yusuf7855/hikaye-oyuncak/cad/onizleme/dis_konsept_on.png

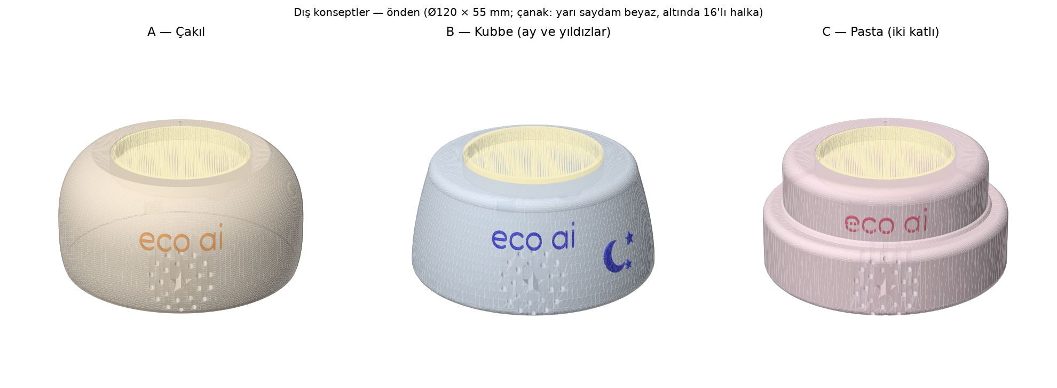
cad/onizleme/dis_konsept_on.png
