yusuf7855/hikaye-oyuncak/cad/parca_stl/BENIOKU.md

# Ürün sahibinin verdiği parça STL'leri

- `tp4056_hw373_usbc.stl`: TP4056 Type-C şarj modülü HW-373 (16 Ekim 2026). Ölçüler: kart 28,0 x 17,3 x 1,0 mm, USB-C 9,8 x 3,0 mm, kart kenarından 1,5 mm taşar. `cakil_ic.py` (PARCA, tp_stl) bunu kullanır.
- `esp32s3_devkit.step` (ürün sahibinin dosyası) ve `esp32s3_devkit.stl` (STEP'ten gmsh ile çevrildi): ESP32-S3 DevKit, WROOM-1 modüllü, iki USB-C (17 Ekim 2026). Ölçüler: kart 57,2 x 28,5 x 1,6 mm, modülün anten ucu karttan 6,7 mm taşar (toplam boy 63,9), üst bileşenler 3,4 mm, başlık plastiği 2,5 mm, pinler kartın altından 8,1 mm. `cakil_ic.py` (ESP_*, esp_stl) bunu kullanır.
