yusuf7855/hikaye-oyuncak/cad/teknik_cizim.pdf

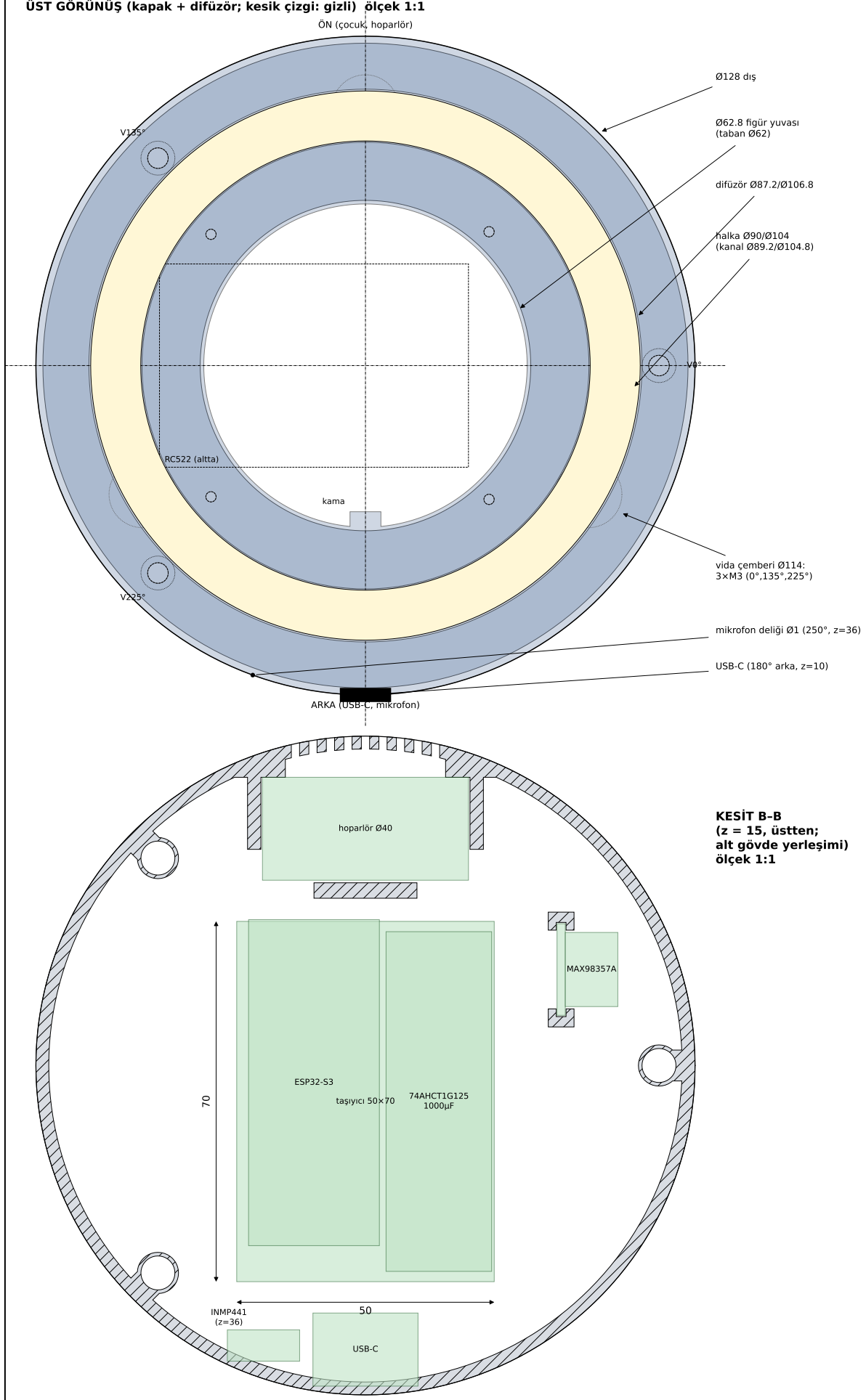
[picture p2: figure]
ÖN (çocuk, hoparlör); ARKA (USB-C, mikrofon); RC522 (altta); mikrofon deliği Ø1 (250°, z=36); USB-C (180° arka, z=10); Ø128 dış; Ø62.8 figür yuvası; (taban Ø62); difüzör Ø87.2/Ø106.8; halka Ø90/Ø104 (kanal Ø89.2/Ø104.8); vida çemberi Ø114: 3×M3 (0°,135°,225°); kama; KESİT B–B; (z = 15, üstten; alt gövde yerleşimi); ölçek 1:1; INMP441 (z=36); taşıyıcı 50×70; ESP32-S3; 74AHCT1G125 1000µF; MAX98357A; hoparlör Ø40; USB-C

### ÜST GÖRÜNÜŞ (kapak + difüzör; kesik çizgi: gizli) ölçek 1:1

## KESİT A–A (x = 0, yandan; sol = arka, sağ = ön) ölçek 1:1

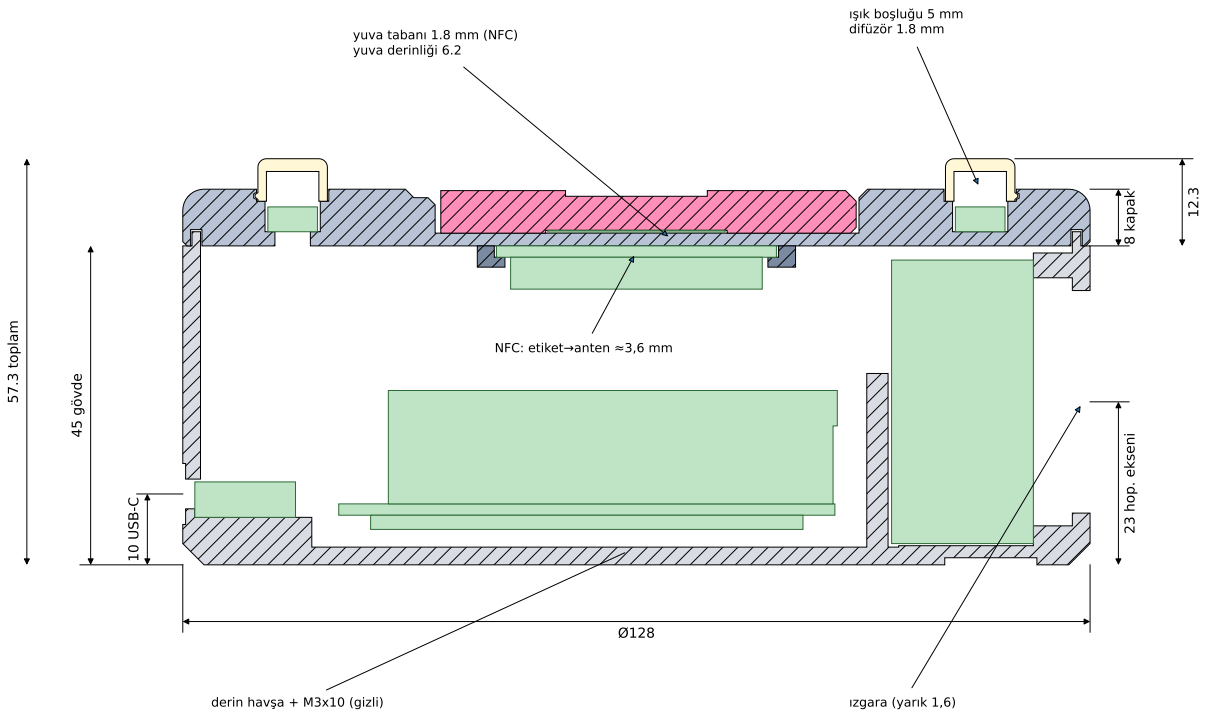
[picture p3: figure]
57.3 toplam; 45 gövde; 8 kapak; 23 hop. ekseni; 10 USB-C; yuva tabanı 1.8 mm (NFC) yuva derinliği 6.2; ışık boşluğu 5 mm; difüzör 1.8 mm; NFC: etiket→anten ≈3,6 mm; derin havşa + M3x10 (gizli); ızgara (yarık 1,6)

## PARÇA LİSTESİ (basılanlar: cad/stl/; elektronik: docs/DONANIM.md)

1 | govde_alt.stl | alt gövde, PETG/PLA | 1
2 | ust_kapak.stl | üst kapak (yuva + halka kanalı), opak | 1
3 | difuzor_halka.stl | difüzör, beyaz yarı saydam PETG | 1
4 | rc522_tutucu.stl | RC522 tutucu çerçeve | 1
5 | figurler/<kimlik>.stl | figür tabanı (12 adlı) / figur_taban.stl yazısız | figür başına 1
6 | ayar_karti.stl | ayar kartı tabanı (topuzlu, AYAR) | 1
7 | ESP32-S3-DevKitC-1 N16R8 | taşıyıcıda dişi headerlara takılı | 1
8 | 5×7 cm delikli pertinaks | 4 köşe kenetli kızakta | 1
9 | MAX98357A + 40 mm 4 Ω 3 W hoparlör | dikey kızak / ön bölme, köpük conta | 1+1
10 | INMP441 | arka iç ped, 1 mm köpük conta | 1
11 | RC522 (bileşen yüzü aşağı) | tutucu ile kapağa 4×M2,5x8 sac vidası | 1
12 | NeoPixel halka Ø104/Ø90 | kanalda, kablo arkadan aşağı | 1
13 | USB-C kartı (5,1 kΩ CC) | arka platform, epoksi + kablo bağı | 1
14 | M3 ısıl gömme somun M3×5,7 + M3×10 vida | kapak–gövde | 3+3
15 | Silikon ayak Ø12,7×3,5 | tabandaki yuvalara | 3
16 | NTAG213 Ø25 etiket | taban altındaki 0,4 mm cebe | figür başına 1

Genel tolerans ±0,2. Boşluklar: yuva–taban 0,4 radyal; halka kanalı 0,4 radyal; dil–oluk 0,2; kartlar 0,25–0,3.

Kenarlar: alt dış pah 3×45°, kapak üst R3. Vidalar alttan, derin havşada gizli.

Ölçüler mm. Bu çizim cad/uret.py ile parametreler.py'den üretilir; elle düzenlemeyin.

# MASAL STANDI — teknik çizim

A3 · ölçek 1:1 · Ø128 × 57.3 mm · hikaye-oyuncak/cad · sayfa 1/2
