yusuf7855/hikaye-oyuncak/docs/YAPILACAKLAR.md

# Yapılacaklar

## Durum (2026-11-10): veri 28 bine çıktı, son model ürüne girdi

- 13 ürün figürü (Keloğlan + 12 yeni) için figür başına ~1000 hikâye yazıldı (urun_v5, 11 974). Bütün veriyle
  (28 493 hikâye) eğitilen son model **c3ft_urun13** (`modeller/c3ft_urun13`, eğitim etiketi c3ft_v5) kör kıyasta
  ara modeli (102–78 / 99–73) ve Keloğlan'da eski ürün modelini (34–14 / 29–15) geçti. Model boyutu aynı (10,3 MB).
- Kartın parmak izi `fp=8091ae97`. Ses modeli de hazır: `modeller/ses/ses.bin` (C = PyTorch denemesi geçti). Sıradaki:
  gerçek kartta ilk deneme (model + ses).
- Bekleyen küçük işler: halka renkleri (Tontiş = Keloğlan yeşili, Bulut beyazı boşta halkasıyla, Ejderha turkuazı
  ayar kartına yakın; ürün sahibi şimdilik önemsiz dedi), `kapi.py` K1.plan_ad "tek tek" = "Tek Boynuzlu At" sanılıyor
  (8 test bu yüzden kırmızı).

## Haftaya (2026-10-12 haftası): veriyi 20–30 bine çıkar

Durum (2026-10-06): 10 597 hikâyeli c3ft_karma, 1030 hikâyeli c3ft_urun1030s2'yi kör kıyasta açık farkla geçti
(genel 127–37, olay örgüsü 112–41; `degerlendirme/urun_kiyas_karma/OZET.md`). Veri artışı olay örgüsünü iyileştiren tek
şey oldu; model boyutu aynı kalıyor (c3, 10,3 MB, ESP32-S3 N16R8'e sığar).

Durum (2026-10-14): **urun_v4 hazır, toplu yazım başlamadı.** 11 figüre 775'er (8525) yeni tohum (tohum 4041, kimlik
2001'den; urun_v3 ile kelime üçlüsü, (yer, tema, isim) hücresi ve kimlik çakışması 0) + gece figürü Ay Dede'ye 1500
tohum (750 ninni, 750 uyku masalı; kart `gece`, kılavuz `degerlendirme/KILAVUZ_GECE.md`). 426 istem
(`data/urun_v4/istem/`), iş listesi `data/urun_v4/isler.json` (424 iş; pilot istemleri niloya_1 ve gece_1 yazıldı).
Toplama: `urun_hafif_topla.py topla urun_v4` + `birlestir urun_karma2 urun_v3 urun_v4` (40 gece metni
`gece_ayri/` altında ayrı tutulur). Gece verisiyle eğitilen model pakete girince `urun_uret.GECE_MODELDE = True`.

Karar (2026-10-15): **ninniler sabit** — kartta 100 anonim halk ninnisi (`firmware/hikaye_oyuncak/ninniler.txt`),
gece figürü modeli hiç çalıştırmaz. urun_v4'teki gece (ninni/uyku masalı) verisi ürün modeline gerekmez; bir sonraki
eğitimde `birlestir` gece metinlerini dışarıda bırakabilir.

Adımlar:
1. Yeni tohumlar: `data/urun_v3/tohum/` gibi figür başına ~950 → ~2000–2800 (farklı seed; mevcut tohumlarla çakışma
   olmasın), istemleri üret (`data/urun_v3/istem/`, scratchpad `v3_istem.py` mantığı; 24 tohum/istem).
2. Hafif hat yazım (yazar + kod kontrolü, hakemsiz): `v3_yaz.js` workflow, 4 kol × 12'li grup. 10 bin ≈ 14 saat;
   konteyner yeniden başlarsa bitmemiş istemleri (kontrol/*.json olmayanlar) yeniden başlat.
3. `urun_hafif_topla.py topla` + `birlestir` (yeni klasör için V3 yolunu genişlet ya da urun_v4 ekle).
4. Eğitim: `IZIN=data/urun_karma/izin.txt TEKRAR=2 GENEL=4000000 STEPS=<6000 × veri/10 bin> TAG=c3ft_karma2 zincir_urun.sh`
   (aynı 10 bin veride 12 bin adım 6000'den kötü çıktı: val 2,054 / 2,015; adımı veriyle orantılı artır.
   Arka plan görevi 2 saatte kesilir, train kaldığı yerden sürer).
   Disk dolabilir: önce eski `data/tr_c*`, `runs/ple-c2*` vb. temizle.
5. Kör kıyas c3ft_karma2 – c3ft_karma: `urun_uret.py --aday 8 --tekrar-vaka 4` + 8 hakem (IKILI_GENEL/IKILI),
   anahtar hakemlik süresince klasör dışında; ardından rubrik puanı (RUBRIK.md).

## Sonra
- ESP32 yazılımını ürün figürlerine (11 figür, kart kataloğu) uyarla ve c3ft_karma'yı cihaza koy; cihaz hâlâ eski hayvan
  kataloğunu kullanıyor. Cihazda K=5 aday kuyruğu (hazır yoksa yazdıkça okuma), web'de K=4.
