yusuf7855/hikaye-oyuncak/data/oyuncak_hikayeleri/YAZIM_KILAVUZU.md

# Oyuncak hikâyeleri yazım kılavuzu

Hedef dinleyici: 3–6 yaş. Hikâyeler bir oyuncak tarafından sesli okunacak ve küçük bir dil modelinin
ince ayarında kullanılacak. Model bu hikâyeleri taklit edeceği için TUTARLILIK ve SADELİK en önemli şey.

## Biçim (kesin)
Her hikâye şu blokla başlar, bloklar arasında bir boş satır:

### <karakter> | <yer> | <tema>
<hikâye metni, paragraflar arasında boş satır olabilir>

- <karakter>: tavşan, kedi, ayı, köpek, ejderha, kız, oğlan, kuş
- <yer>: orman, deniz, ev, park, şato, dağ
- Başlık satırı dışında "###" kullanma. Hikâyeye başlık koyma.

## İçerik kuralları
- Uzunluk: 120–220 kelime.
- Yapı: tanıtım → küçük bir sorun → çocuğun anlayacağı bir çözüm → sıcak, mutlu son (bir ders/duygu).
- Ana karakter hikâyenin başında açıkça tanıtılır ve olay seçilen yerde geçer.
- Kısa, basit cümleler. 3–6 yaşın bildiği kelimeler. Mecaz, deyim, zor kelime yok.
- Doğru ve doğal Türkçe: masal diline uygun geçmiş zaman (-dı / -mış), tutarlı zaman kullanımı.
- İsimler Türkçe: Elif, Ali, Zeynep, Can, Defne, Ege, Mert, Ela, Kerem, Nil, Deniz, Umut, Ada, Emir…
  Hayvanlara sevimli isim verilebilir: Pamuk, Minik, Boncuk, Karamel, Fındık, Tarçın, Zıpzıp…
- Her isim ve tür hikâye boyunca AYNI kalır. Bir karakter bir yerde tavşansa hep tavşandır.
- Olaylar mantıklı sırayla ilerler; bir karakter yapmadığı bir şey için teşekkür almaz.
- Diyaloglar kısa, çift tırnakla: "Merhaba!" dedi Pamuk.
- Korku en fazla hafif ve hemen giderilir. Şiddet, yaralanma, ölüm, marka, teknoloji ürünü, gerçek kişi yok.
- Açılışları çeşitlendir: "Bir zamanlar", "Bir varmış bir yokmuş", "Güneşli bir sabah", "Ormanın derinliklerinde"…
  Aynı açılışı üst üste kullanma.
- Her hikâye kendi içinde farklı olsun: aynı olay örgüsünü kelimeleri değiştirip tekrar etme.

## Temalar (her yer için her temadan tam bir hikâye)
paylaşmak, yeni arkadaş edinmek, korkuyu yenmek, kaybolan bir şeyi bulmak, yardım etmek, özür dilemek,
sabırlı olmak, doğayı korumak, sırasını beklemek, dürüstlük, merak ve keşif, hasta bir arkadaşa bakmak,
farklılıklara saygı, birlikte çalışmak, hatadan öğrenmek, doğum günü sürprizi, kıskançlığı yenmek,
uyku vakti, yağmur ya da kar günü, teşekkür etmek
