yusuf7855/hikaye-oyuncak/cad/onizleme/adim_1_halka.png

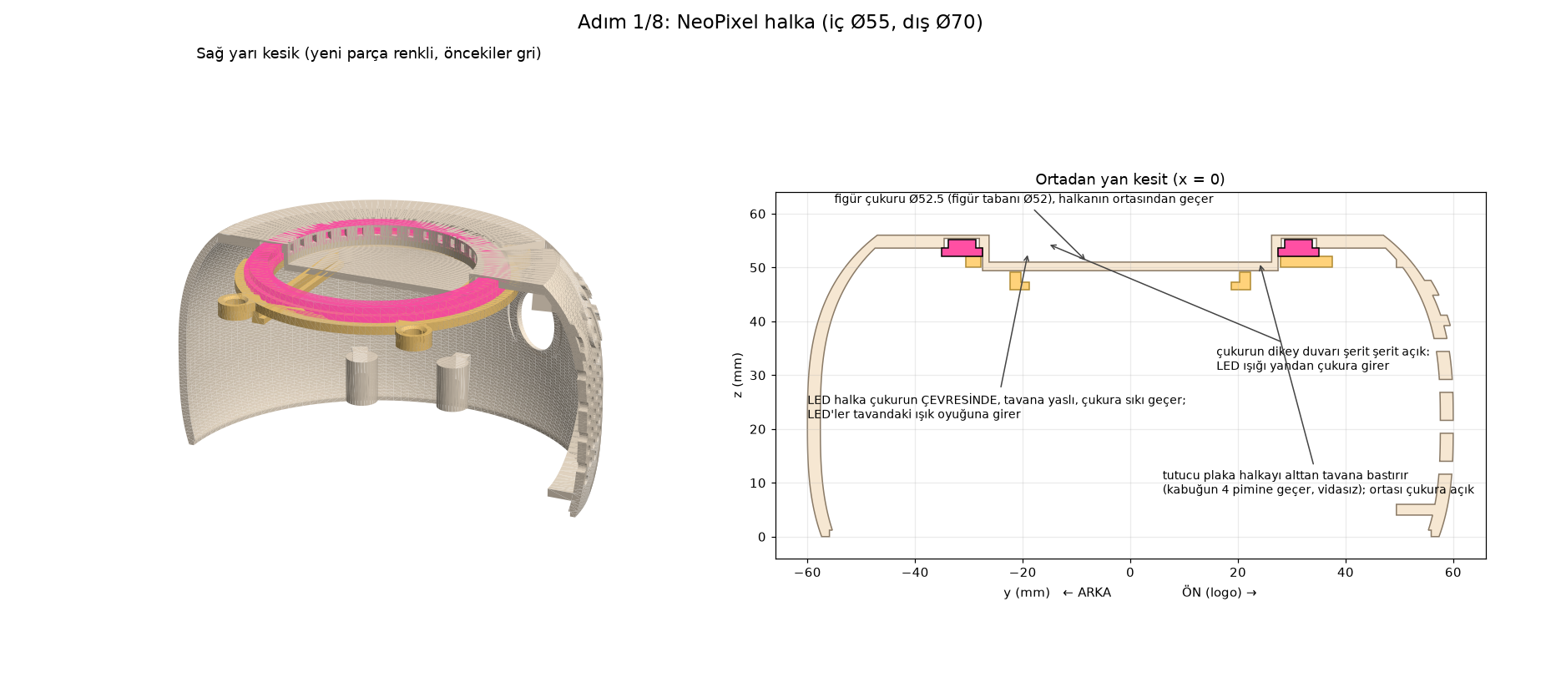
cad/onizleme/adim_1_halka.png
