yusuf7855/hikaye-oyuncak/cad/onizleme/adim_1_ust.png

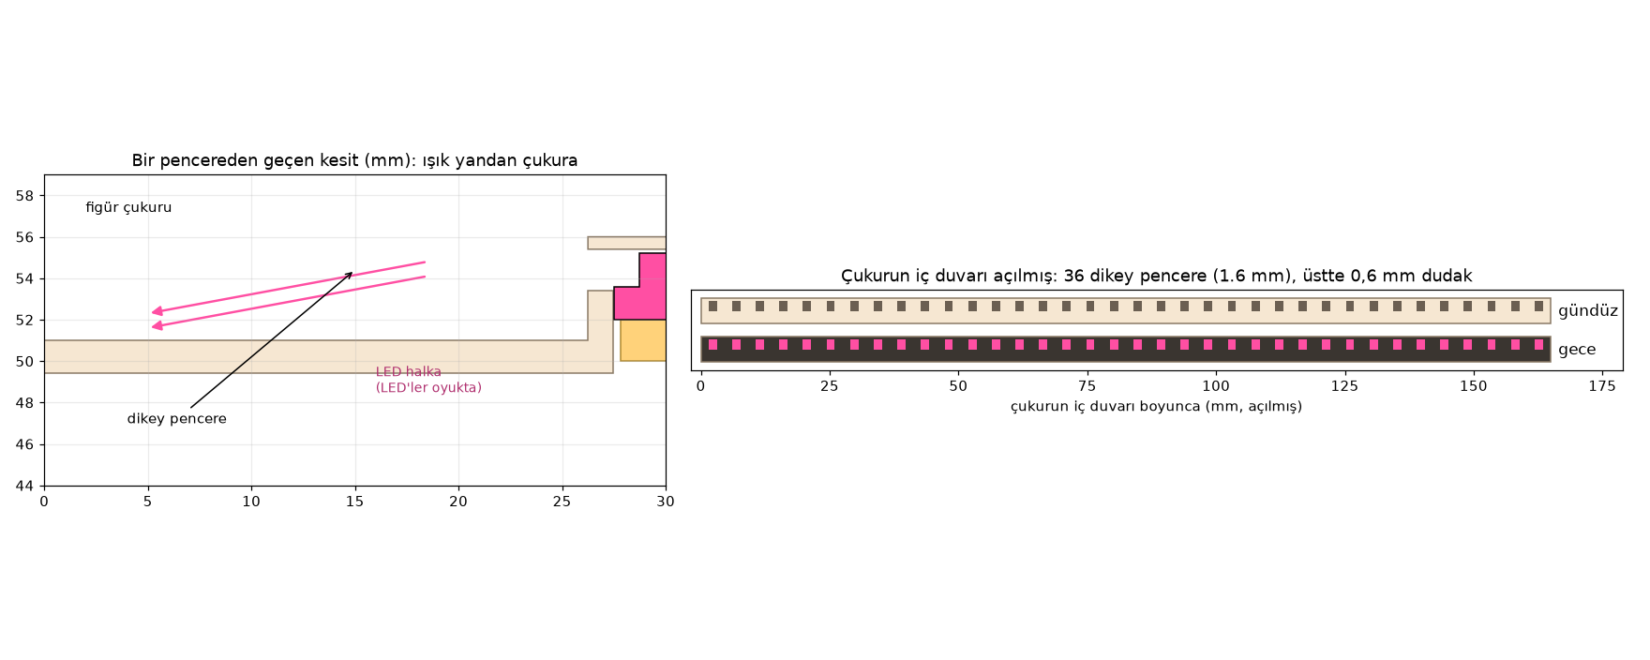
cad/onizleme/adim_1_ust.png
