yusuf7855/hikaye-oyuncak/cad/onizleme/adim_2_nfc_pn5180.png

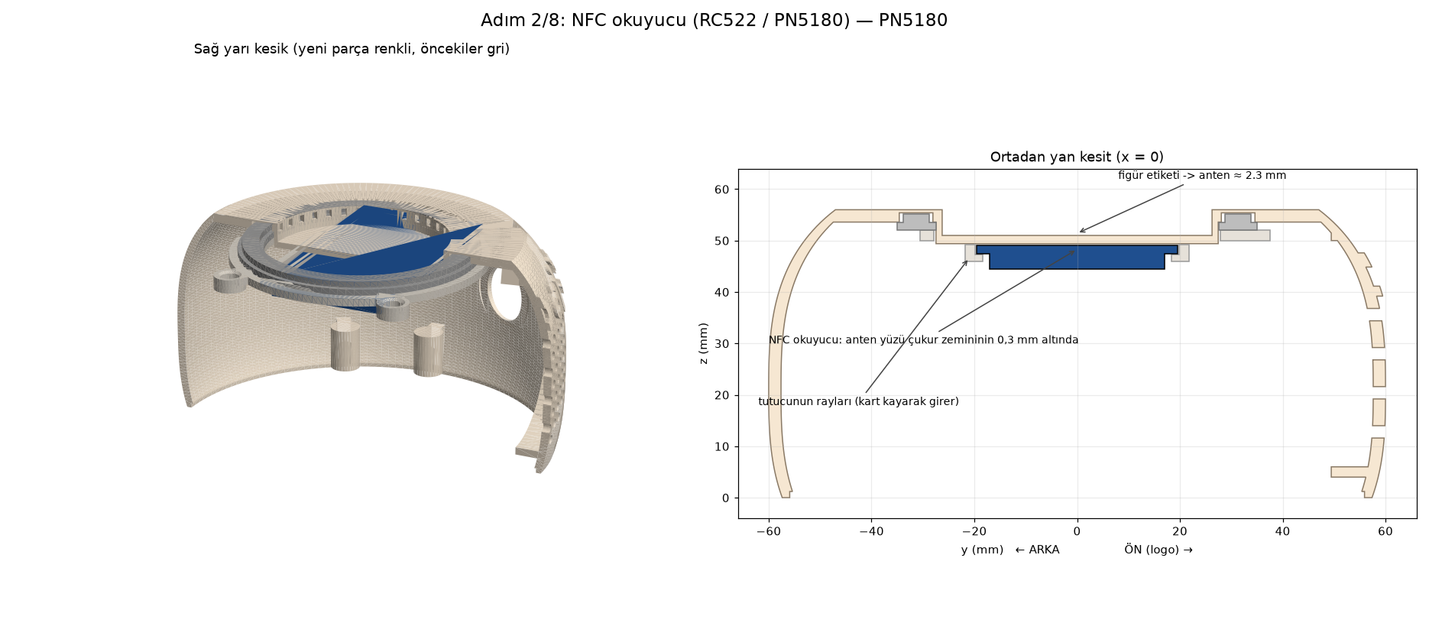
cad/onizleme/adim_2_nfc_pn5180.png
