yusuf7855/hikaye-oyuncak/cad/onizleme/adim_2_nfc_ustten.png

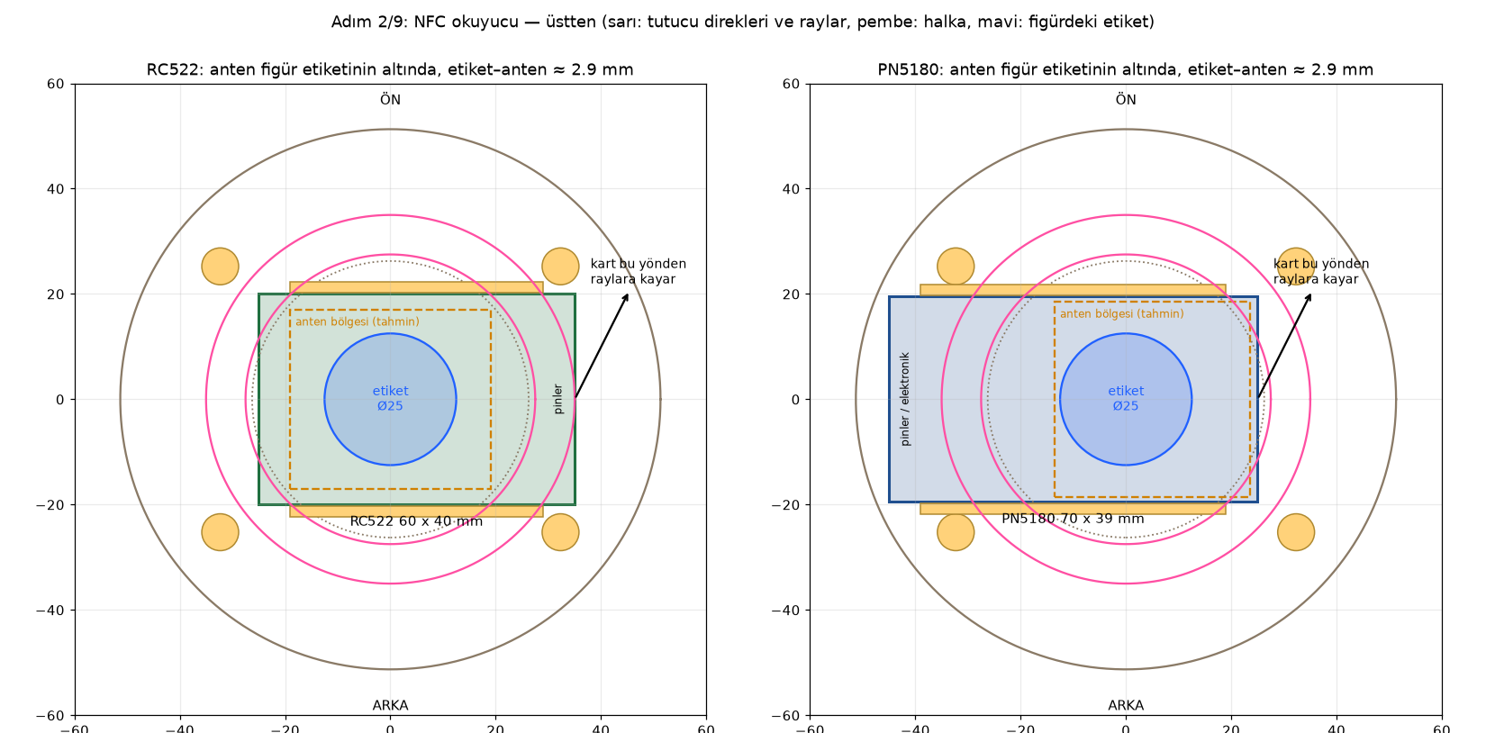
cad/onizleme/adim_2_nfc_ustten.png
