yusuf7855/hikaye-oyuncak/cad/onizleme/adim_3_pil.png

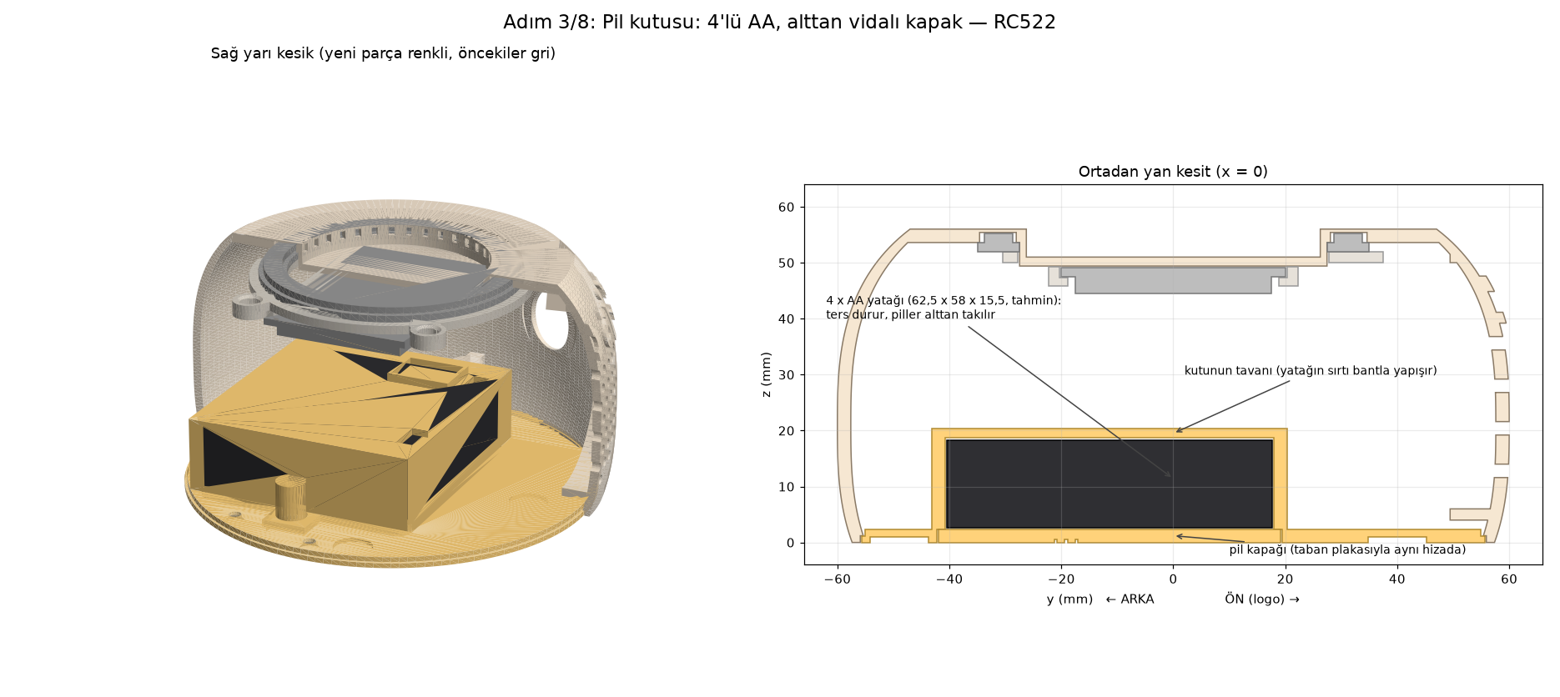
cad/onizleme/adim_3_pil.png
