yusuf7855/hikaye-oyuncak/cad/onizleme/adim_3_taban_plan.png

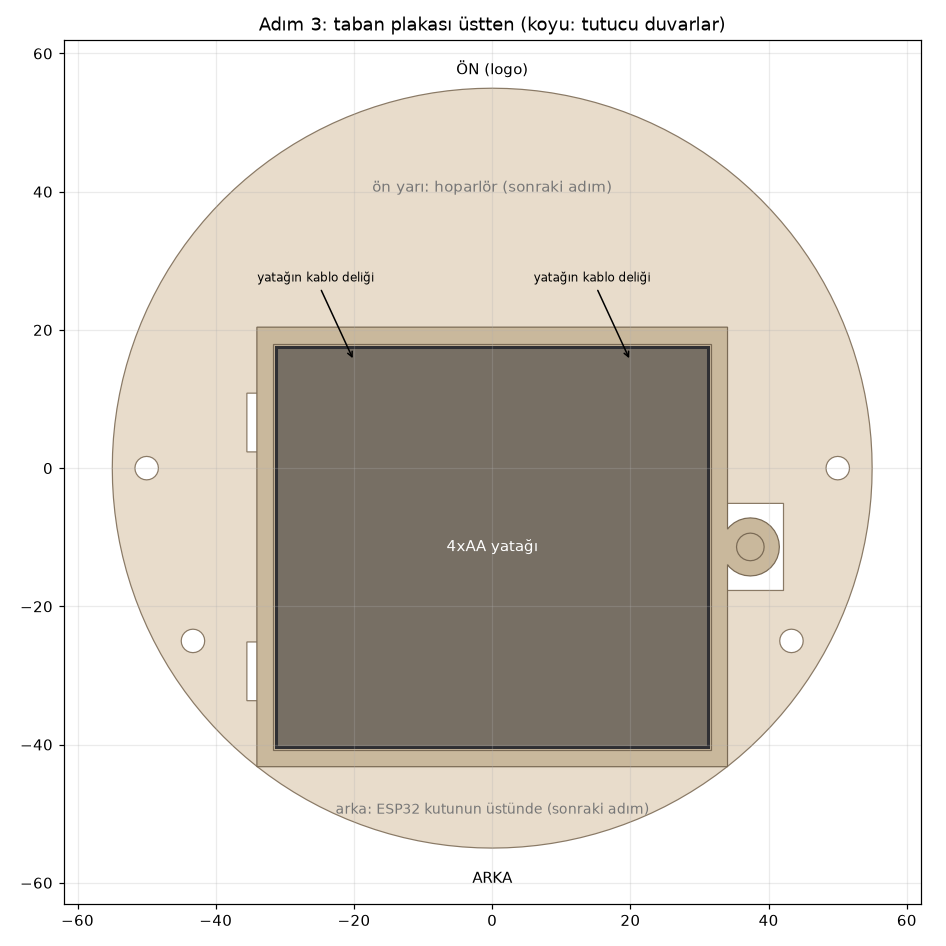
cad/onizleme/adim_3_taban_plan.png
