yusuf7855/hikaye-oyuncak/cad/onizleme/adim_6_esp32.png

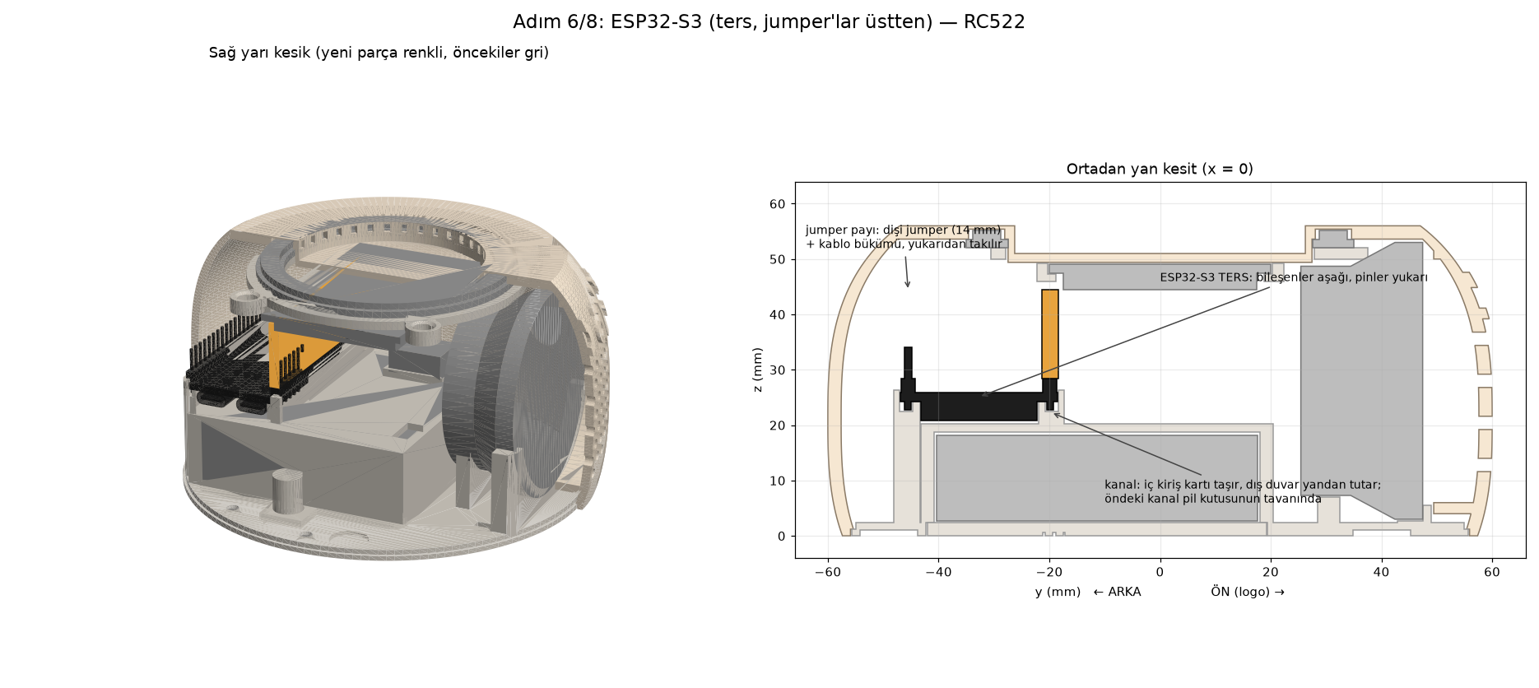
cad/onizleme/adim_6_esp32.png
