yusuf7855/hikaye-oyuncak/cad/onizleme/adim_6_esp32_yakin.png

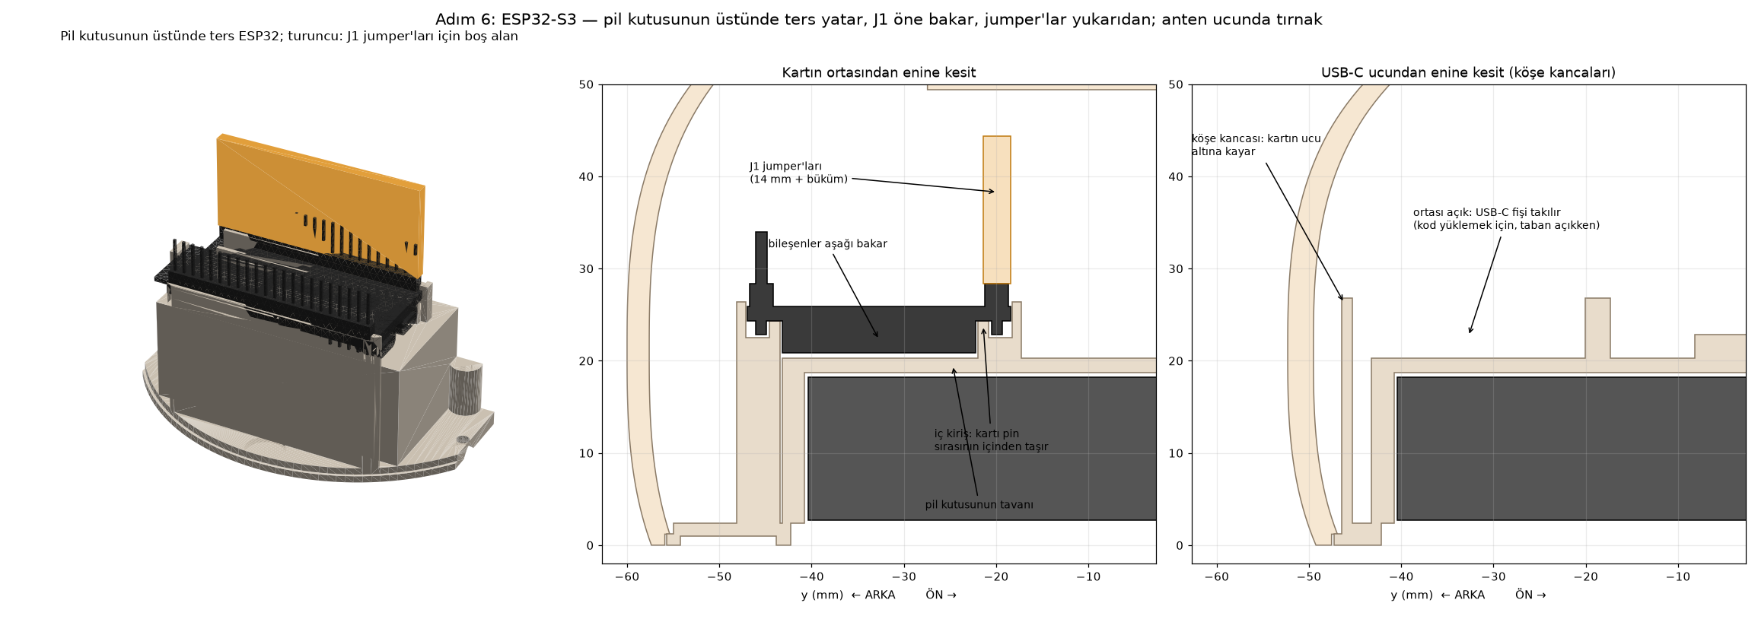
cad/onizleme/adim_6_esp32_yakin.png
