yusuf7855/hikaye-oyuncak/cad/onizleme/adim_8_amfi.png

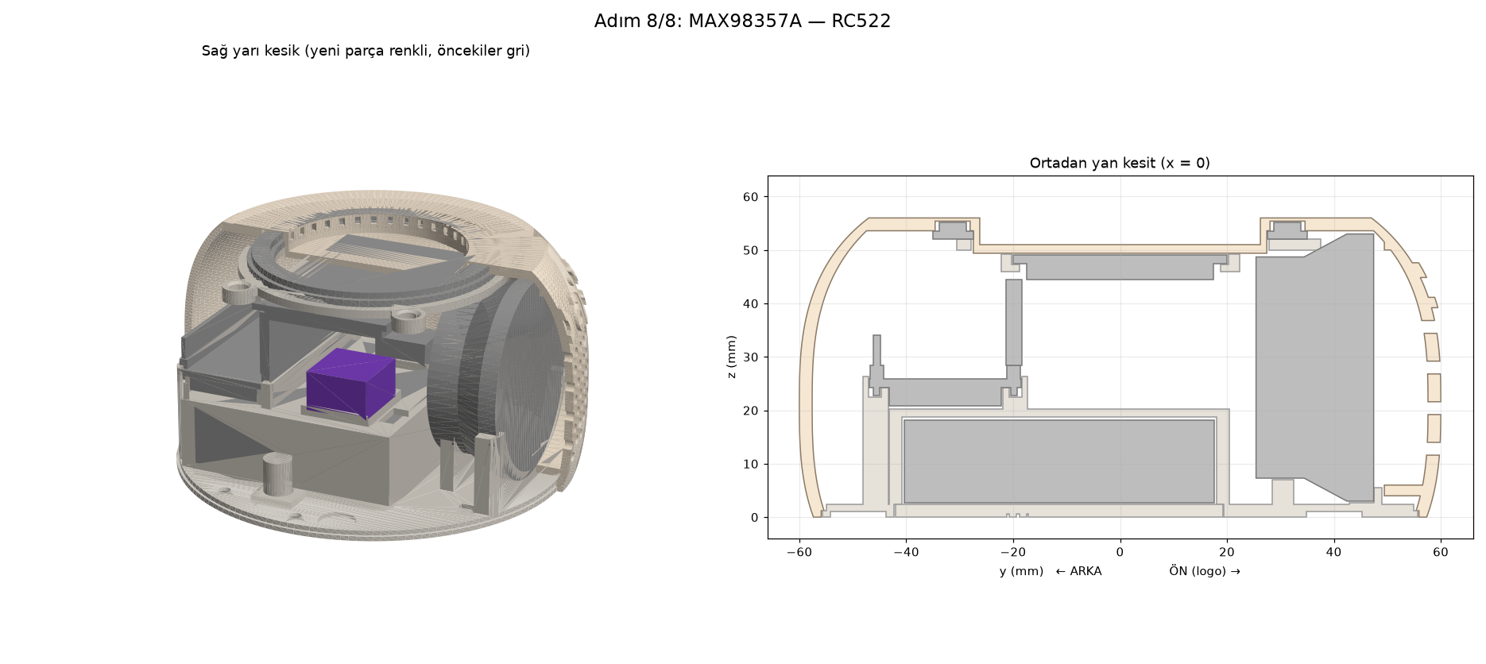
cad/onizleme/adim_8_amfi.png
