yusuf7855/hikaye-oyuncak/cad/onizleme/alt_kapak_3b.png

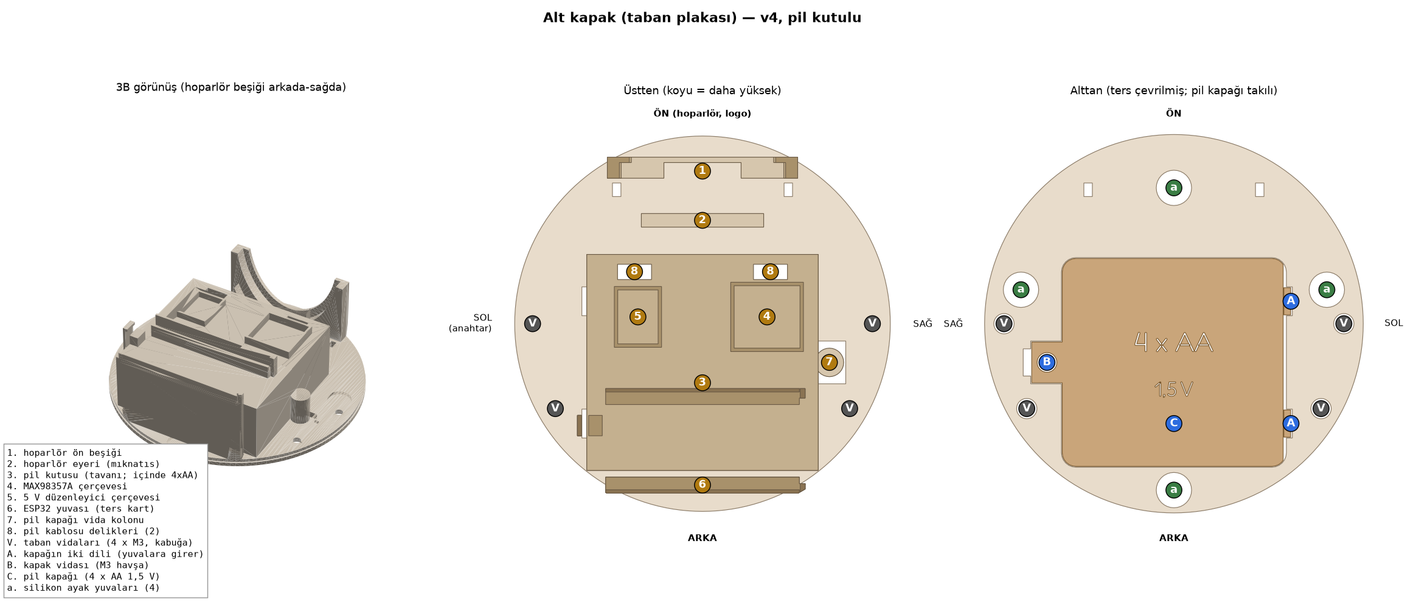
cad/onizleme/alt_kapak_3b.png
