yusuf7855/hikaye-oyuncak/cad/onizleme/alt_kapak_hoparlor_tutucu.png

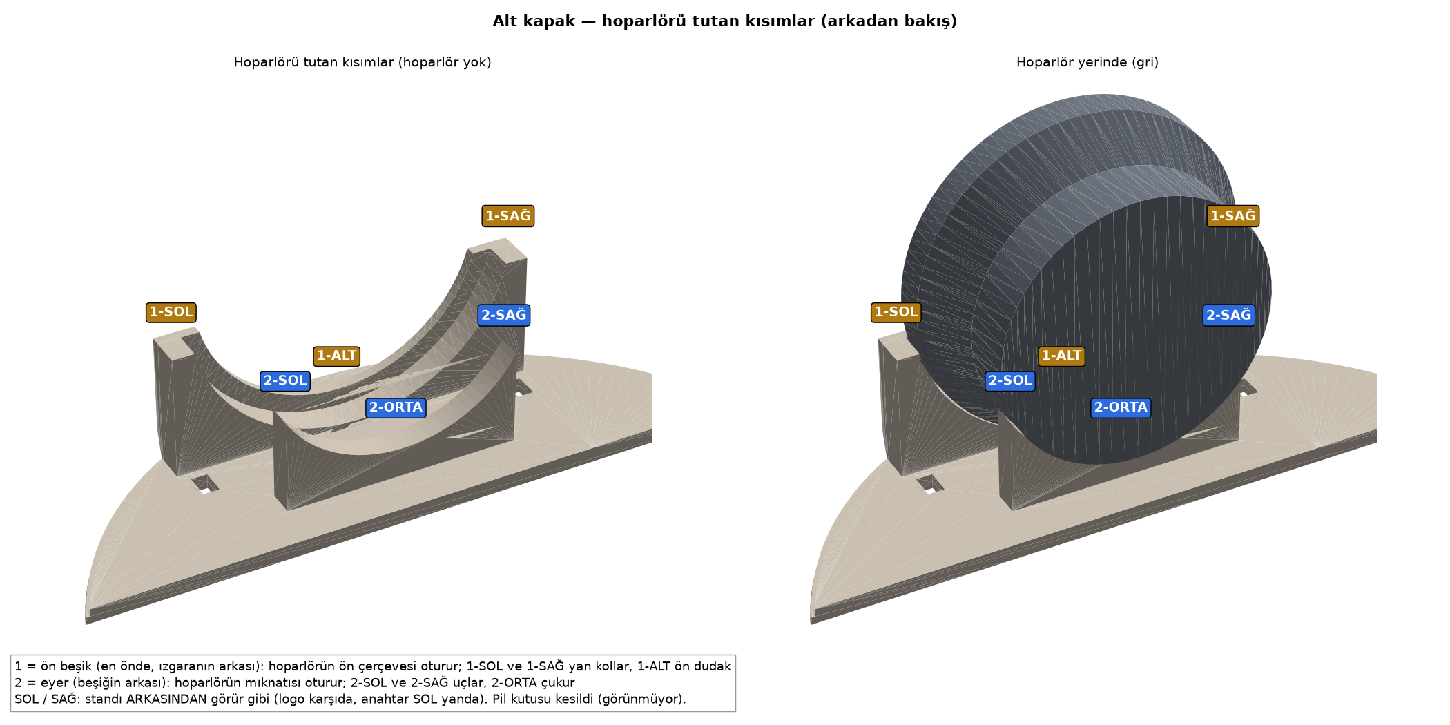
cad/onizleme/alt_kapak_hoparlor_tutucu.png
