yusuf7855/hikaye-oyuncak/cad/onizleme/baski_parcalar_rc522.png

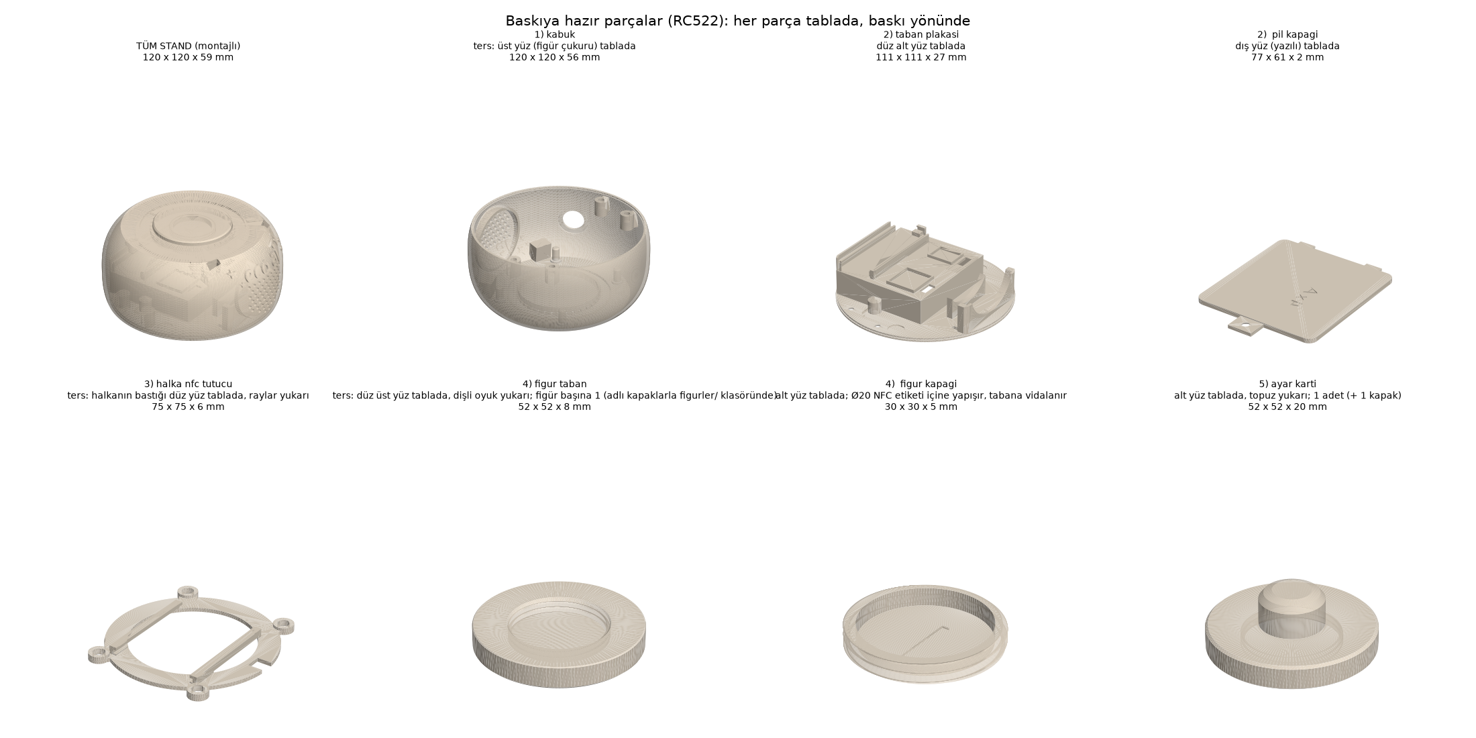
cad/onizleme/baski_parcalar_rc522.png
