yusuf7855/hikaye-oyuncak/cad/onizleme/cakil_gece.png

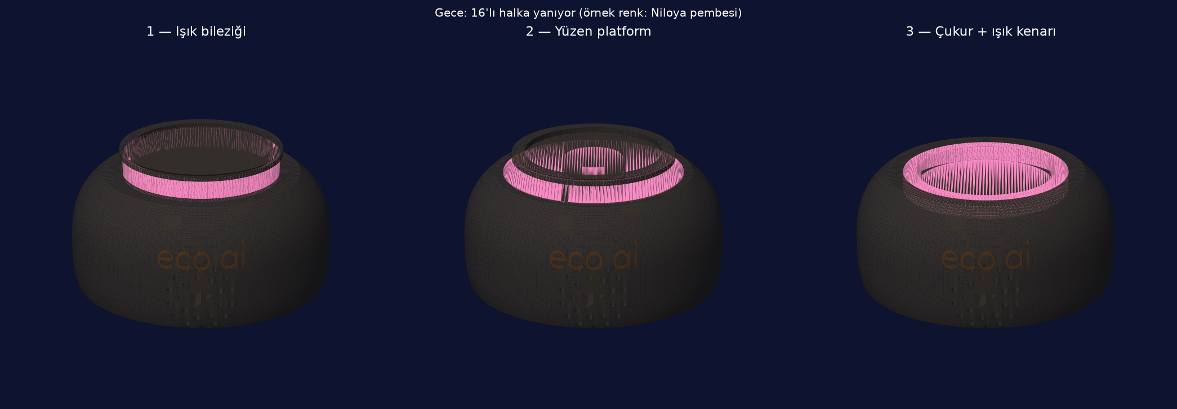
cad/onizleme/cakil_gece.png
