yusuf7855/hikaye-oyuncak/cad/onizleme/cakil_gunduz.png

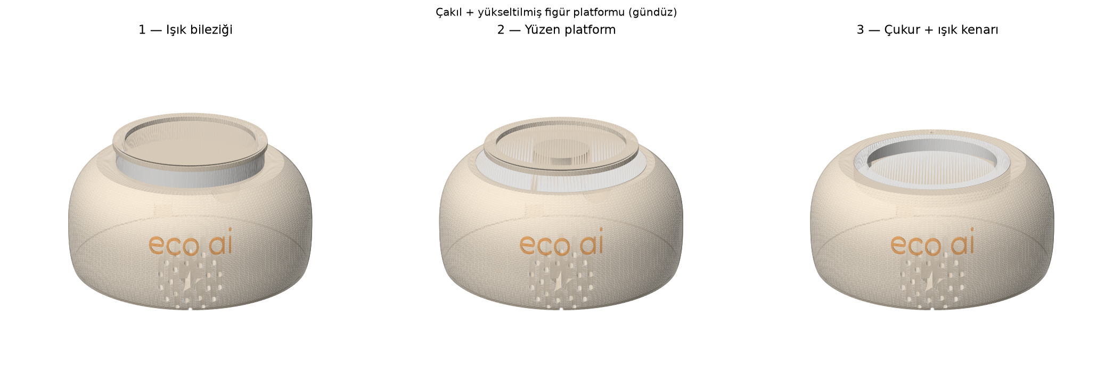
cad/onizleme/cakil_gunduz.png
