yusuf7855/hikaye-oyuncak/cad/onizleme/cakil_ic_plan.png

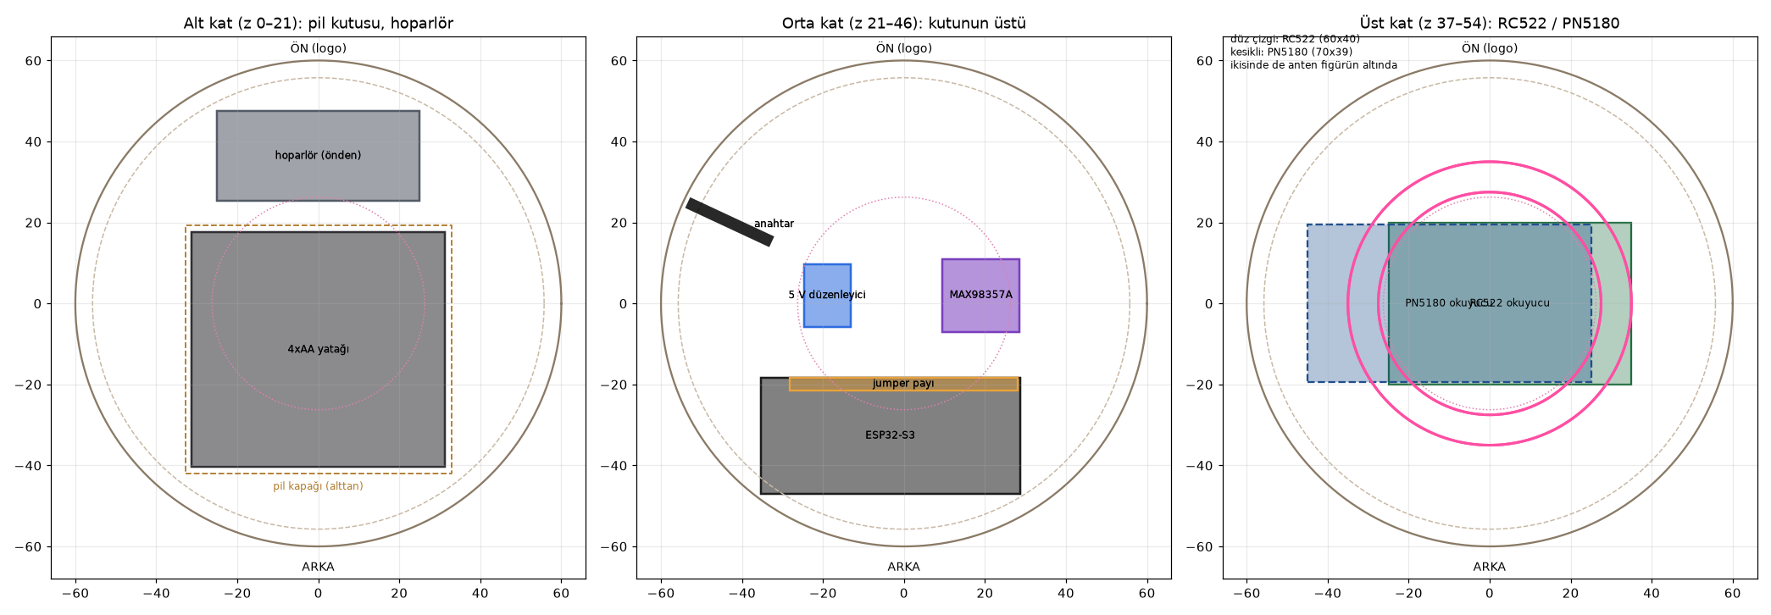
cad/onizleme/cakil_ic_plan.png
