yusuf7855/hikaye-oyuncak/cad/onizleme/dis_konsept_arka.png

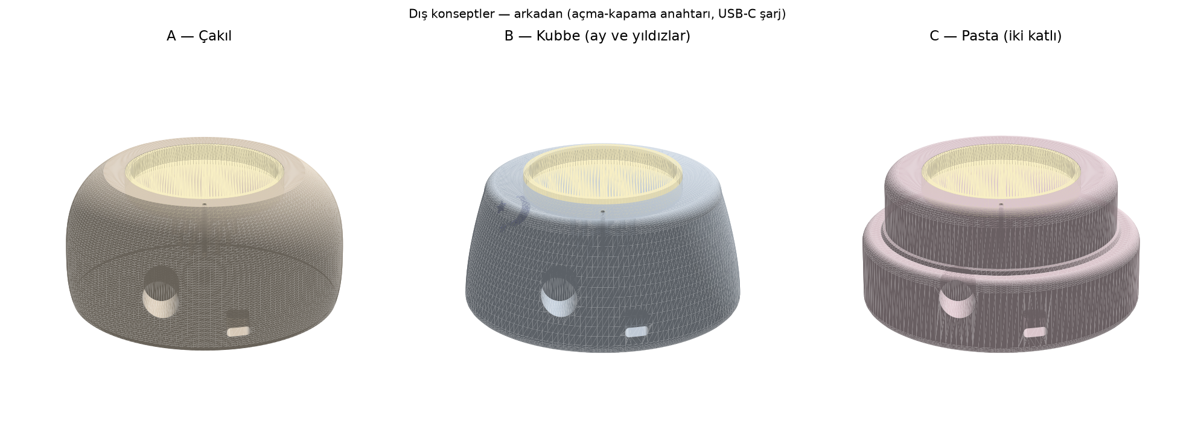
cad/onizleme/dis_konsept_arka.png
