yusuf7855/hikaye-oyuncak/cad/onizleme/figur_tabanlari.png

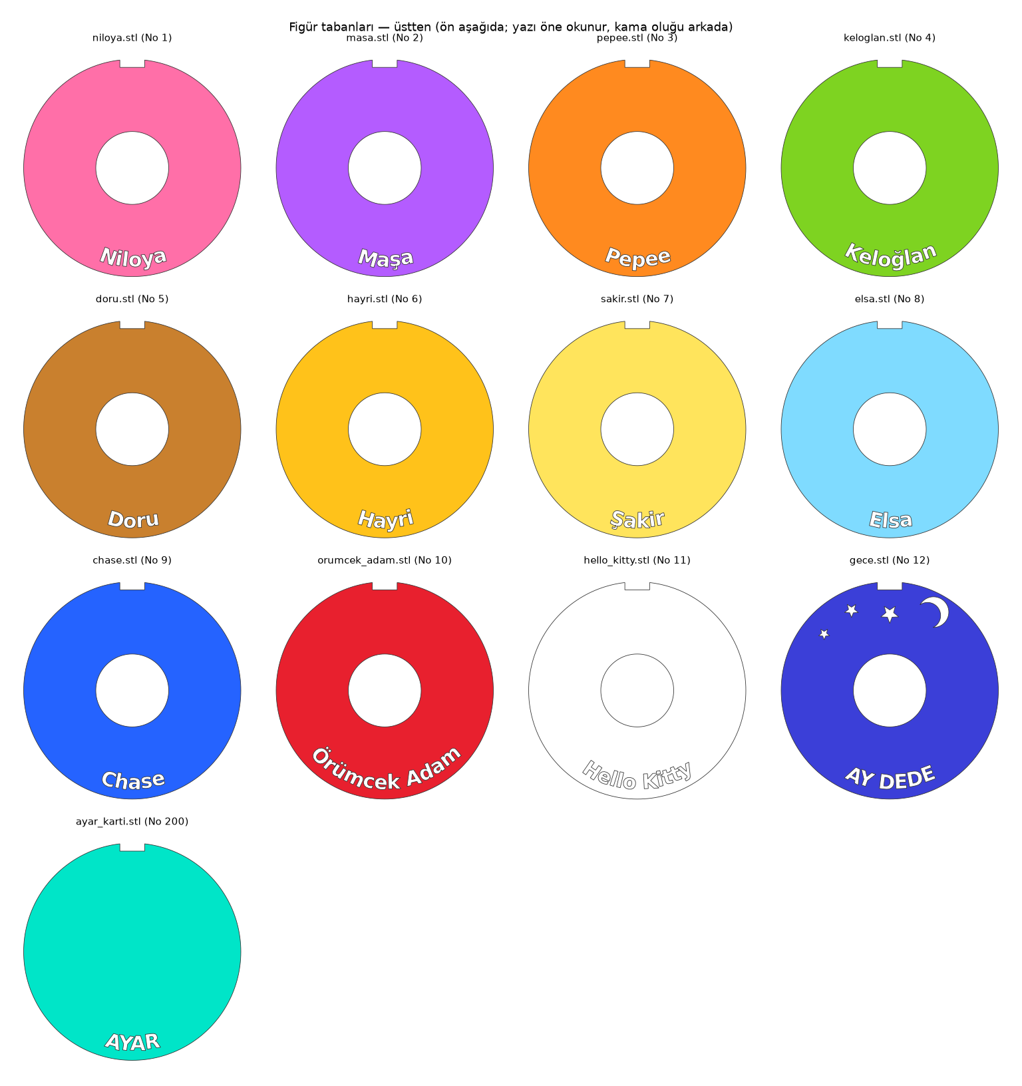
cad/onizleme/figur_tabanlari.png
