yusuf7855/hikaye-oyuncak/cad/onizleme/figurler.png

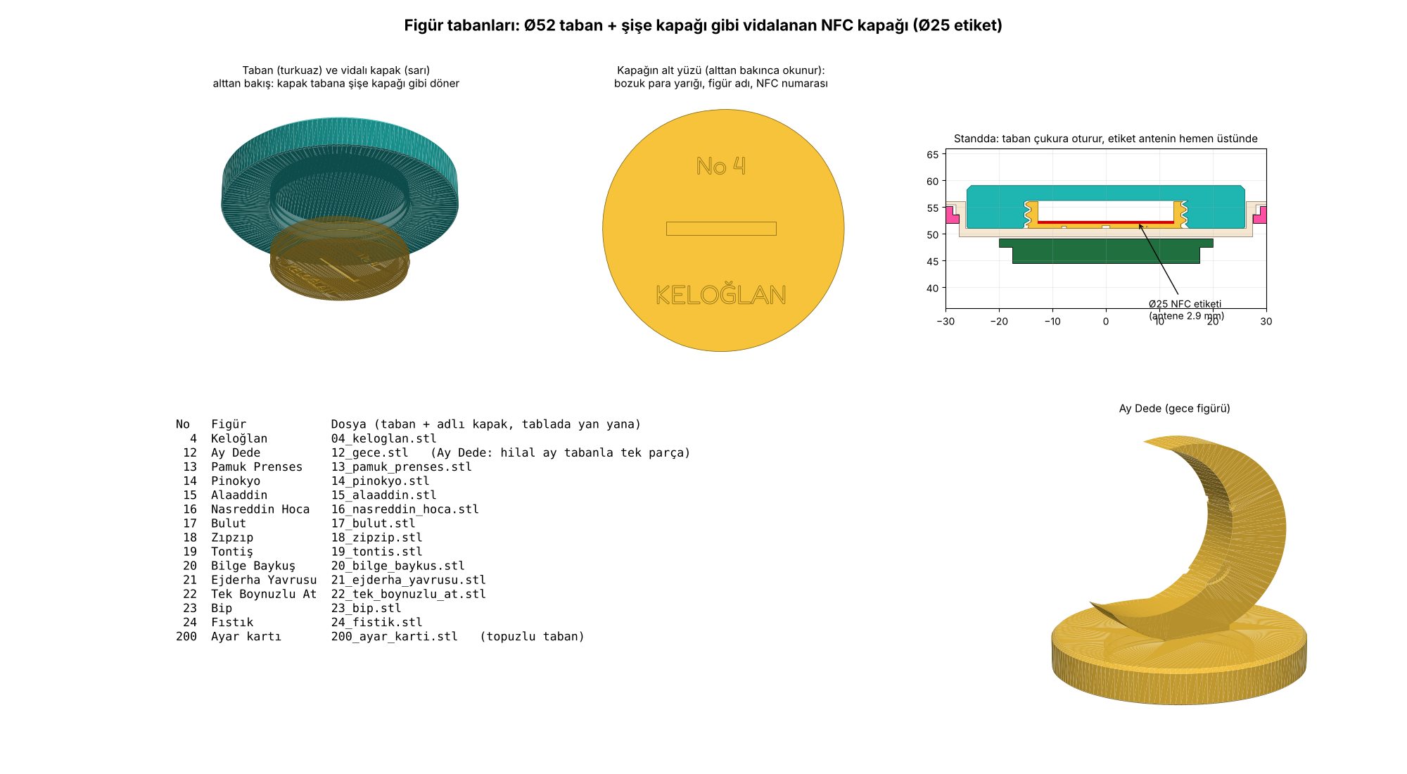
cad/onizleme/figurler.png
