yusuf7855/hikaye-oyuncak/cad/onizleme/govde_ic_yerlesim.png

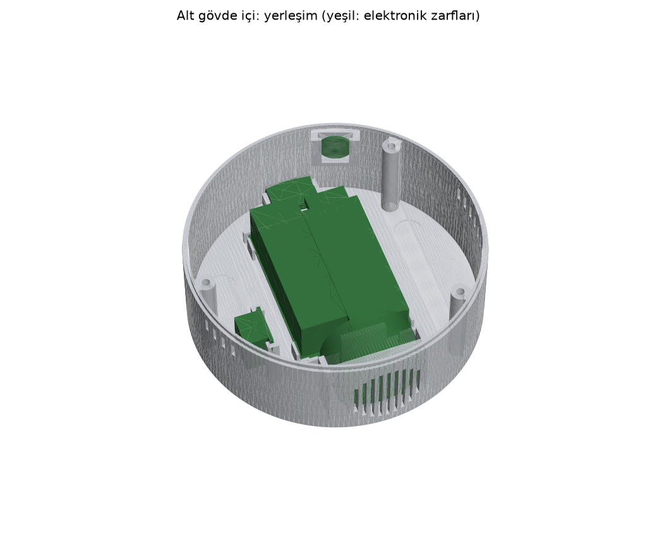
cad/onizleme/govde_ic_yerlesim.png
