yusuf7855/hikaye-oyuncak/cad/onizleme/kabuk_temalar.png

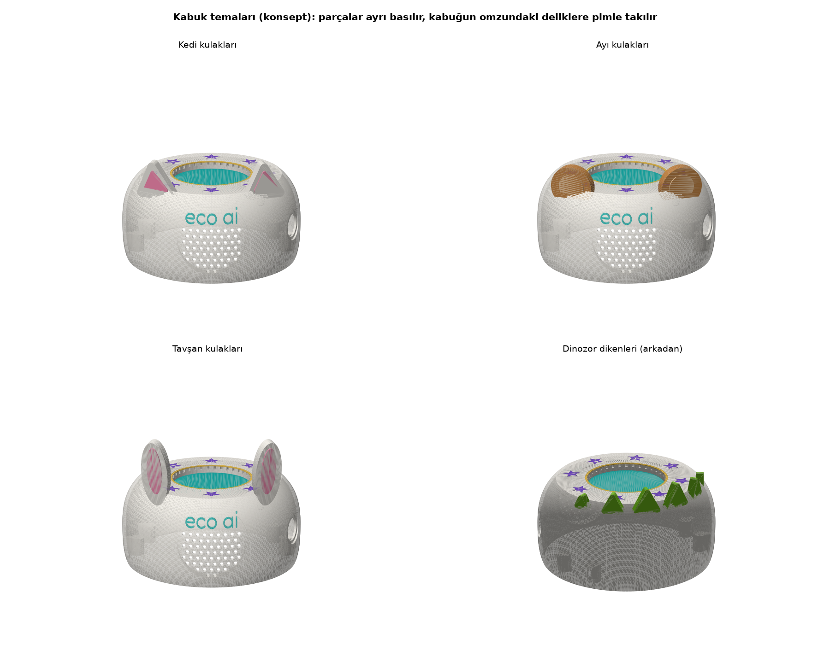
cad/onizleme/kabuk_temalar.png
