yusuf7855/hikaye-oyuncak/cad/onizleme/kabuk_yildizlar.png

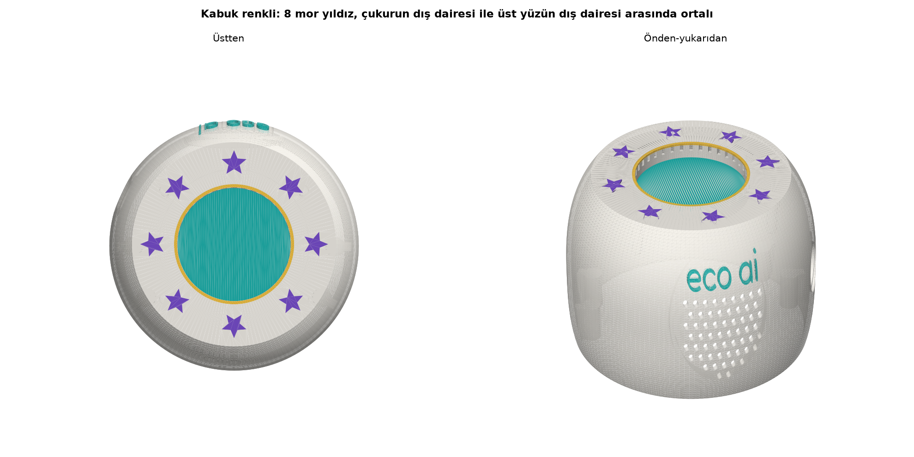
cad/onizleme/kabuk_yildizlar.png
