yusuf7855/hikaye-oyuncak/cad/onizleme/kedi_kulaklari.png

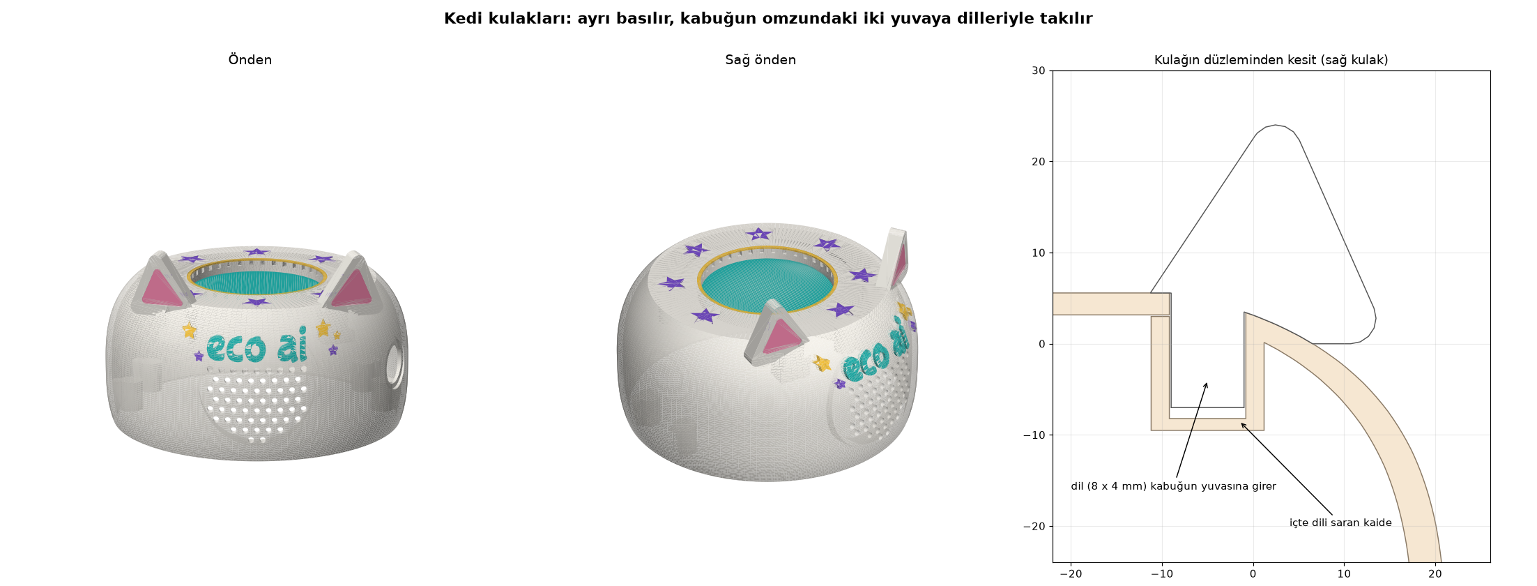
cad/onizleme/kedi_kulaklari.png
