yusuf7855/hikaye-oyuncak/cad/onizleme/parca_difuzor_halka.png

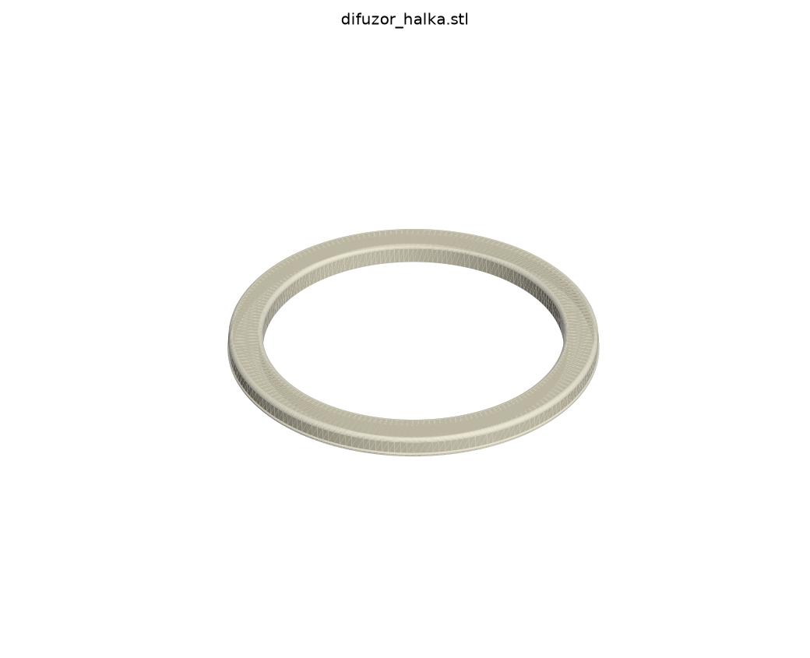
cad/onizleme/parca_difuzor_halka.png
