yusuf7855/hikaye-oyuncak/cad/onizleme/parca_figur_taban_alt.png

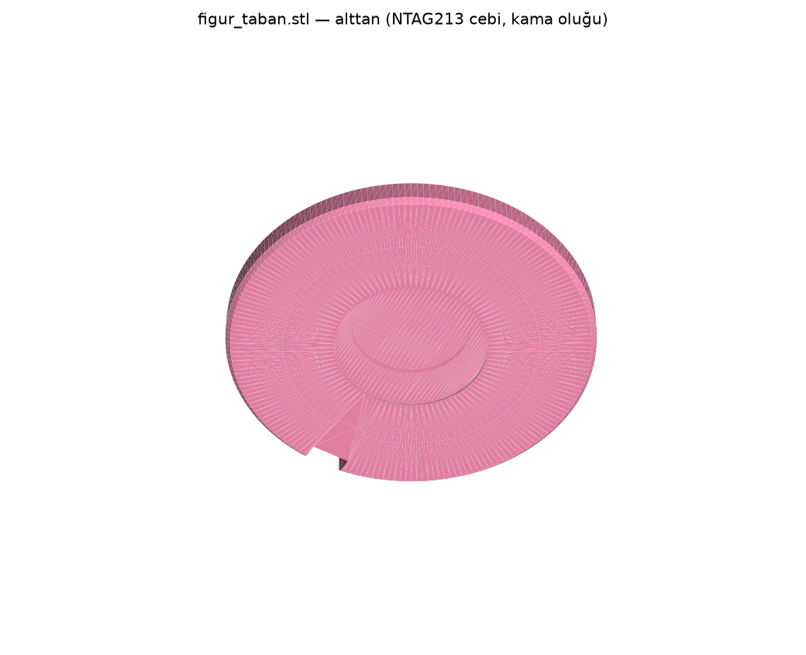
cad/onizleme/parca_figur_taban_alt.png
