yusuf7855/hikaye-oyuncak/cad/onizleme/parca_govde_alt_alt.png

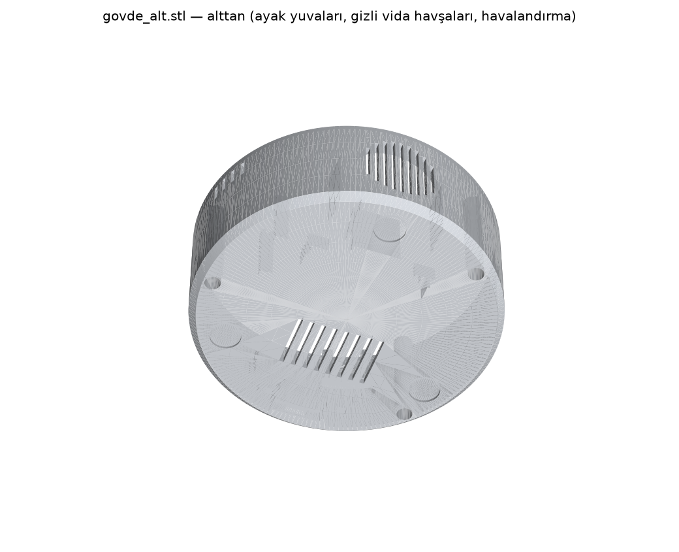
cad/onizleme/parca_govde_alt_alt.png
