yusuf7855/hikaye-oyuncak/cad/onizleme/parca_rc522_tutucu.png

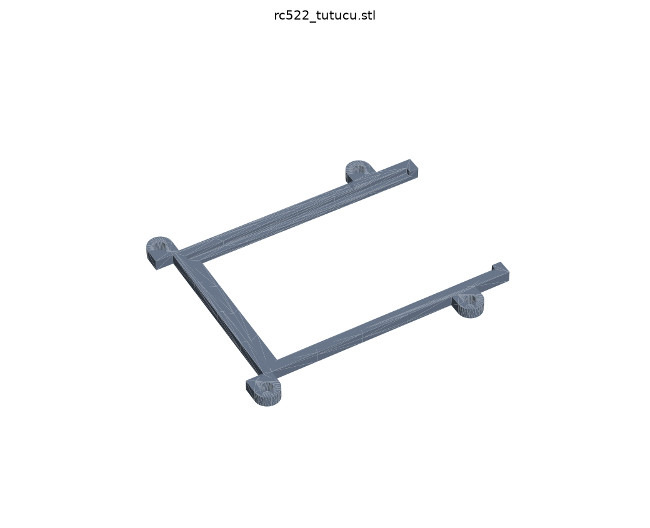
cad/onizleme/parca_rc522_tutucu.png
