yusuf7855/hikaye-oyuncak/cad/onizleme/soru_vida_yuvalari.png

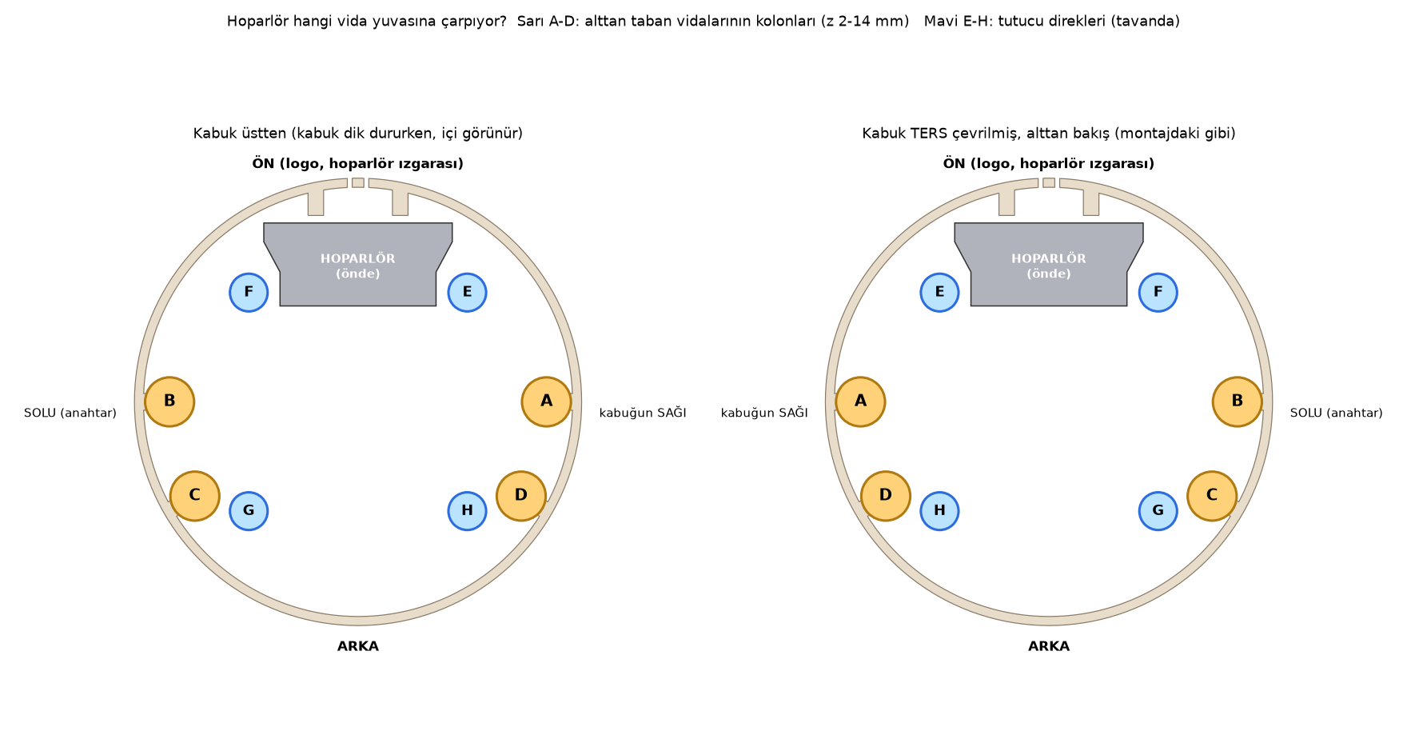
cad/onizleme/soru_vida_yuvalari.png
