yusuf7855/hikaye-oyuncak/cad/onizleme/soru_vida_yuvalari_3b.png

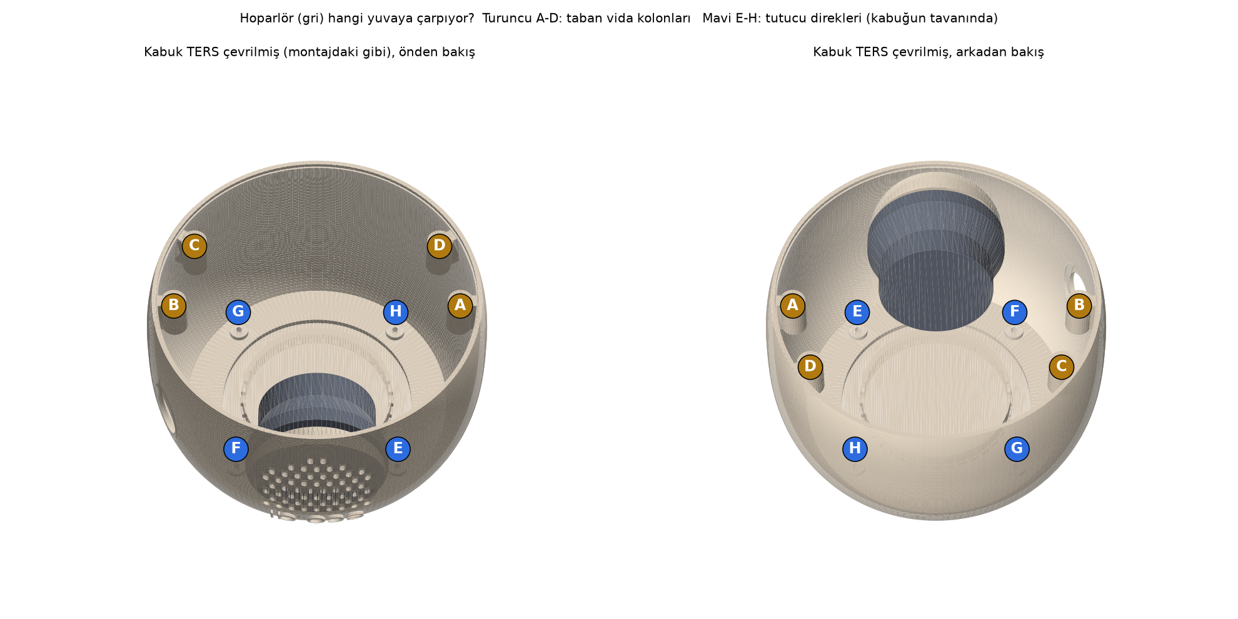
cad/onizleme/soru_vida_yuvalari_3b.png
