yusuf7855/hikaye-oyuncak/cad/onizleme/tutucu_kabukta.png

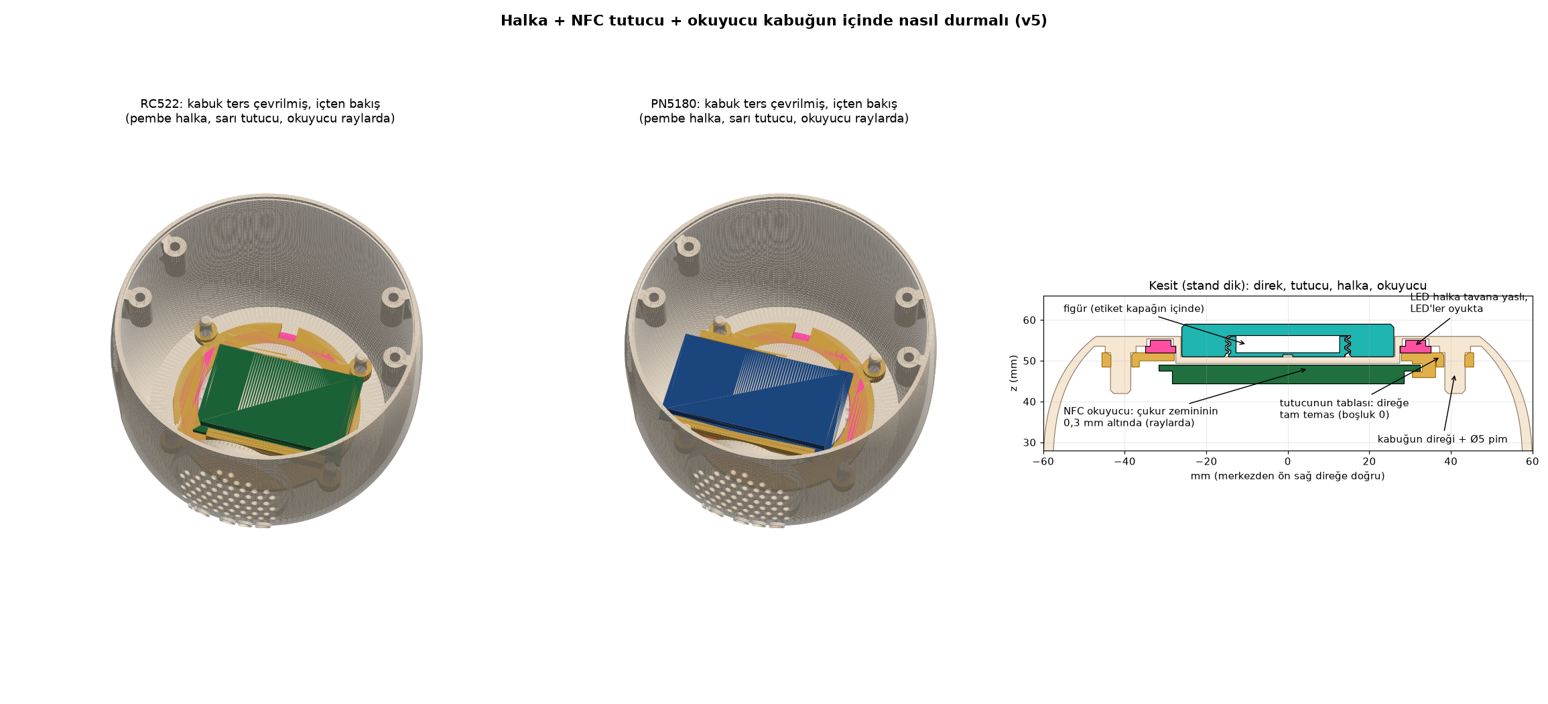
cad/onizleme/tutucu_kabukta.png
