yusuf7855/hikaye-oyuncak/cad/onizleme/yerlesim_rehberi.png

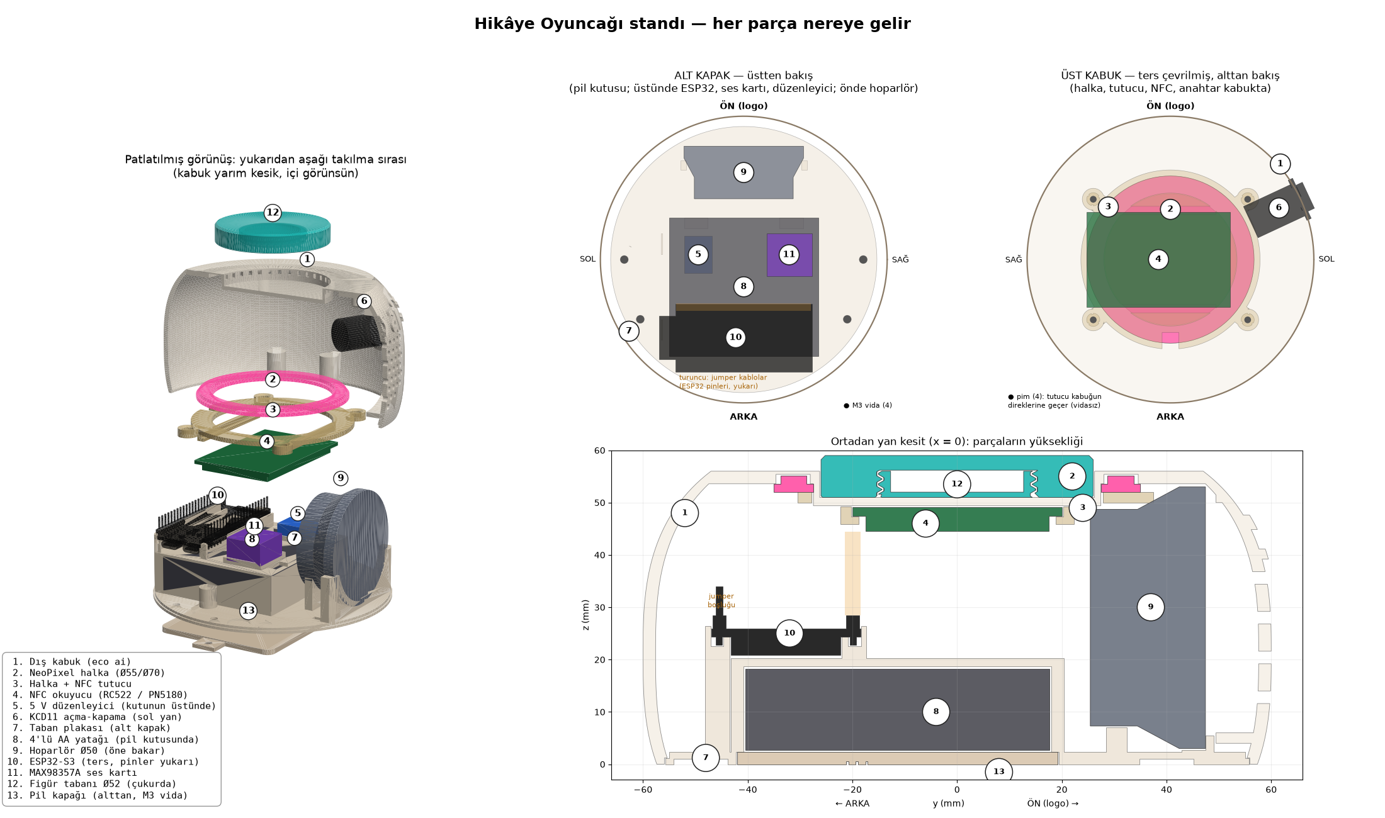
cad/onizleme/yerlesim_rehberi.png
