yusuf7855/hikaye-oyuncak/cad/parca_stl/esp32s3_devkit.stl

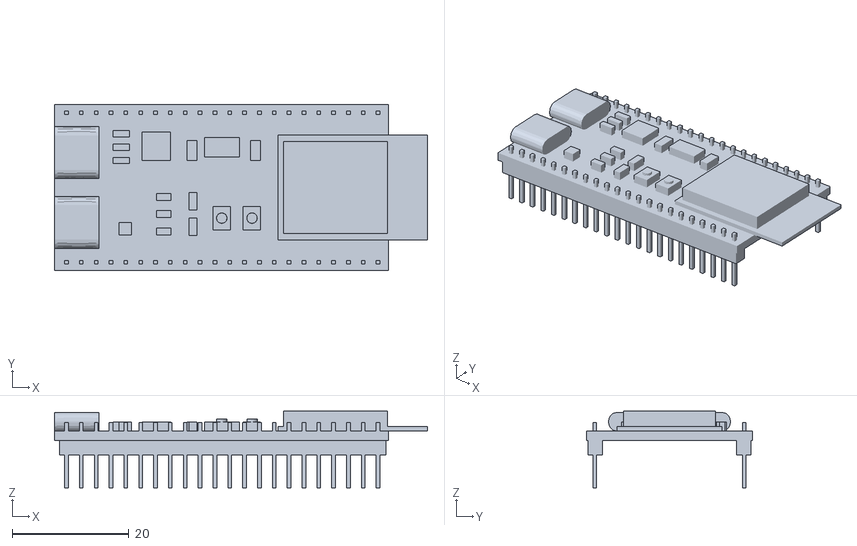
[picture p34: CAD file, 2026-11-10]
cad/parca_stl/esp32s3_devkit.stl
63.8 x 28.5 x 13.1
