yusuf7855/hikaye-oyuncak/cad/step_cakil/halka_nfc_tutucu_rc522.step

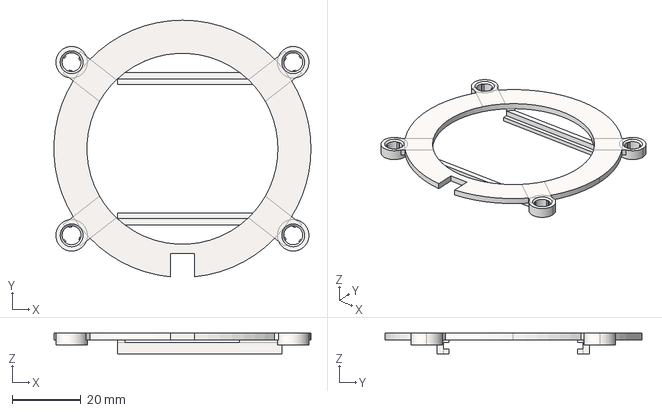
[picture p35: CAD file, 2026-11-10]
cad/step_cakil/halka_nfc_tutucu_rc522.step
75.0 x 74.8 x 6.10 mm
