yusuf7855/hikaye-oyuncak/cad/stl/figurler/keloglan.stl

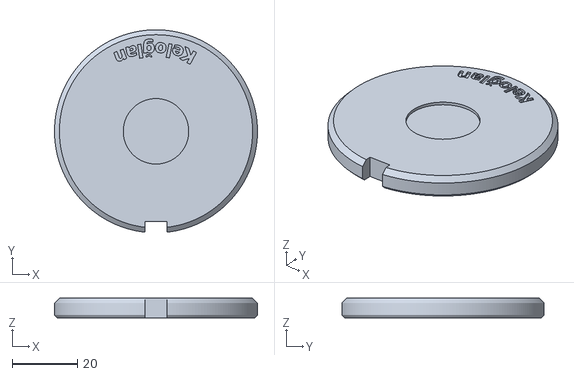
[picture p36: CAD file, 2026-11-10]
cad/stl/figurler/keloglan.stl
62.0 x 61.8 x 6.00
