yusuf7855/hikaye-oyuncak/cad/stl/rc522_tutucu.stl

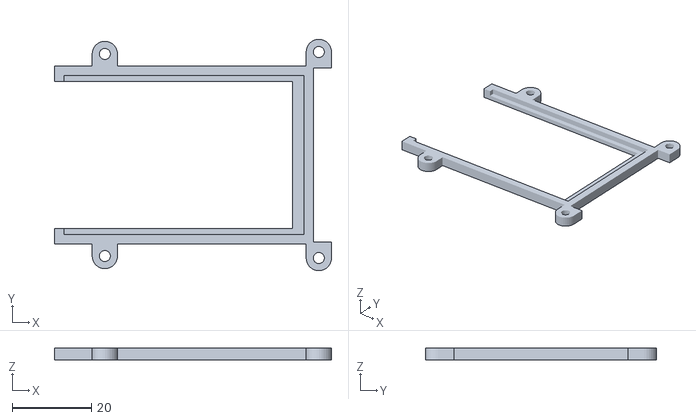
[picture p37: CAD file, 2026-11-10]
cad/stl/rc522_tutucu.stl
69.9 x 58.4 x 3.00
