yusuf7855/hikaye-oyuncak/cad/stl_cakil/figurler/15_alaaddin.stl

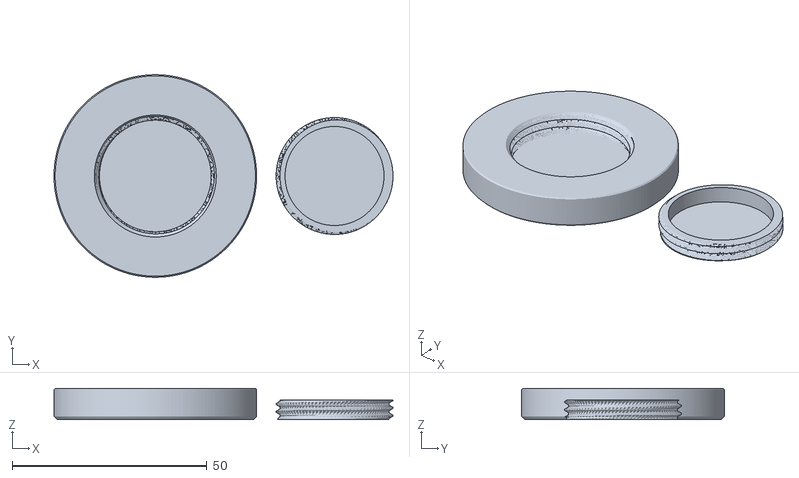
[picture p38: CAD file, 2026-11-10]
cad/stl_cakil/figurler/15_alaaddin.stl
87.0 x 52.0 x 8.00
