yusuf7855/hikaye-oyuncak/cad/stl_cakil/kulak/kedi_kulagi_sol.stl

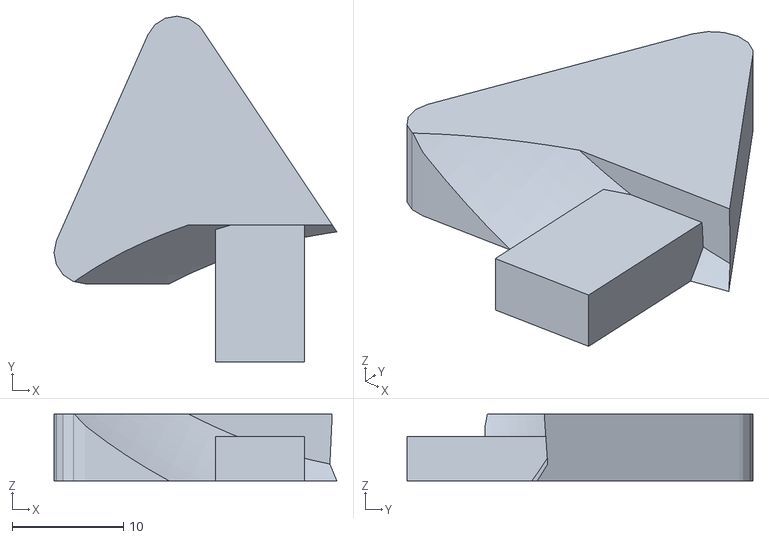
[picture p39: CAD file, 2026-11-10]
cad/stl_cakil/kulak/kedi_kulagi_sol.stl
25.4 x 31.0 x 6.00
