yusuf7855/hikaye-oyuncak/cad/stl_cakil/pn5180/2b_pil_kapagi.stl

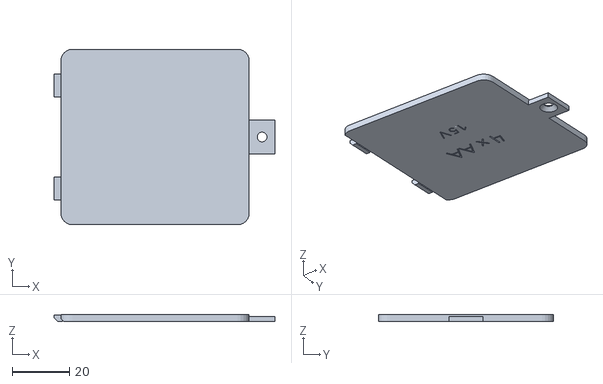
[picture p40: CAD file, 2026-11-10]
cad/stl_cakil/pn5180/2b_pil_kapagi.stl
77.1 x 61.2 x 2.40
