yusuf7855/hikaye-oyuncak/cad/stl_cakil/rc522/0_tum_stand_rc522_montajli.stl

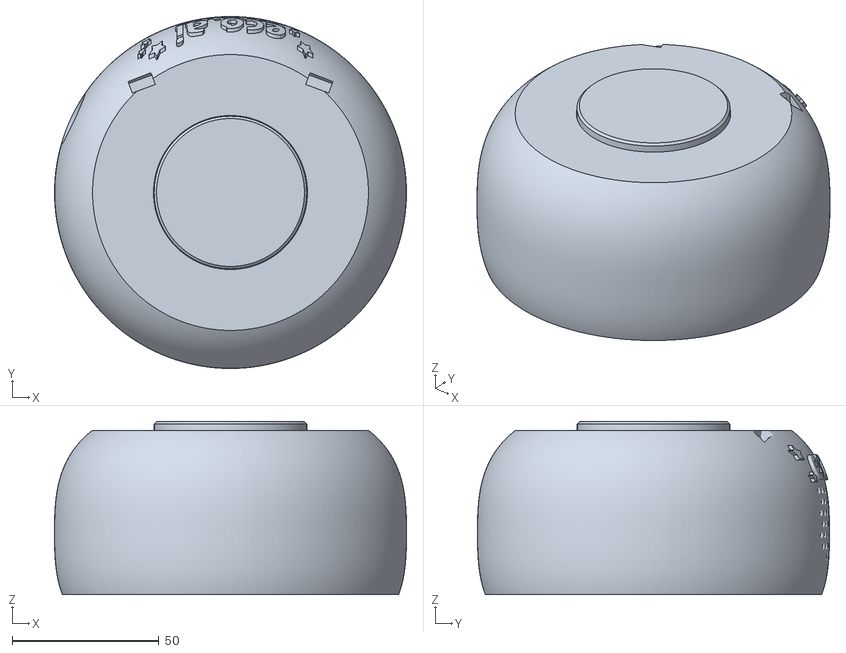
[picture p41: CAD file, 2026-11-10]
cad/stl_cakil/rc522/0_tum_stand_rc522_montajli.stl
120.0 x 120.0 x 59.0
