yusuf7855/hikaye-oyuncak/cad/step_cakil/pil_kapagi.step

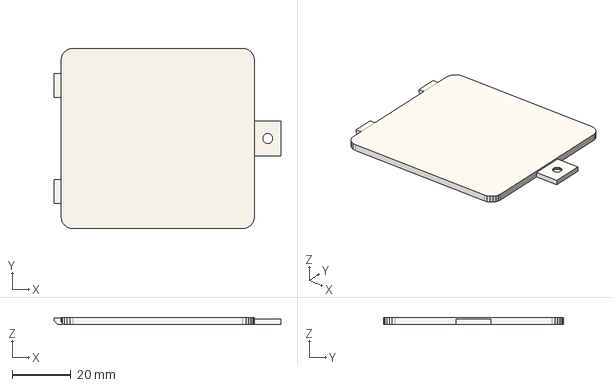
[picture p42: CAD file, 2026-11-10]
cad/step_cakil/pil_kapagi.step
77.1 x 61.2 x 2.40 mm
