yusuf7855/hikaye-oyuncak/cad/stl/ust_kapak.stl

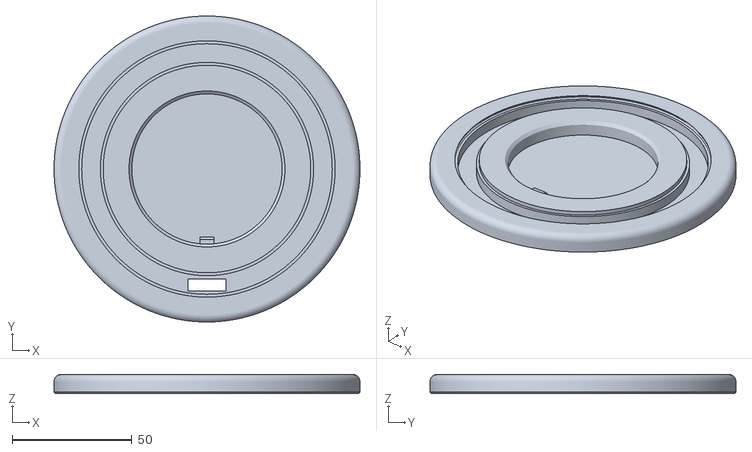
[picture p43: CAD file, 2026-11-10]
cad/stl/ust_kapak.stl
128.0 x 128.0 x 8.00
