yusuf7855/hikaye-oyuncak/cad/stl_cakil/pn5180/0_tum_stand_pn5180_elektronikli_GORSEL.stl

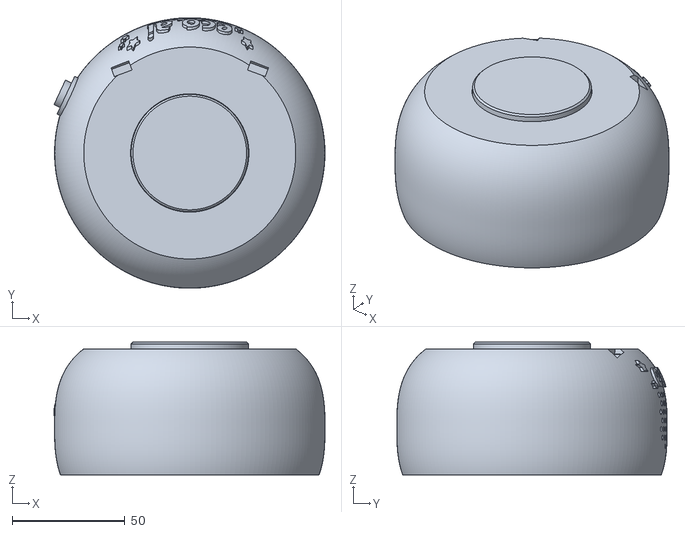
[picture p44: CAD file, 2026-11-10]
cad/stl_cakil/pn5180/0_tum_stand_pn5180_elektronikli_GORSEL.stl
120.2 x 120.0 x 59.0
