yusuf7855/hikaye-oyuncak/cad/stl_cakil/renkli_bambu/2_taban_plakasi_1_beyaz.stl

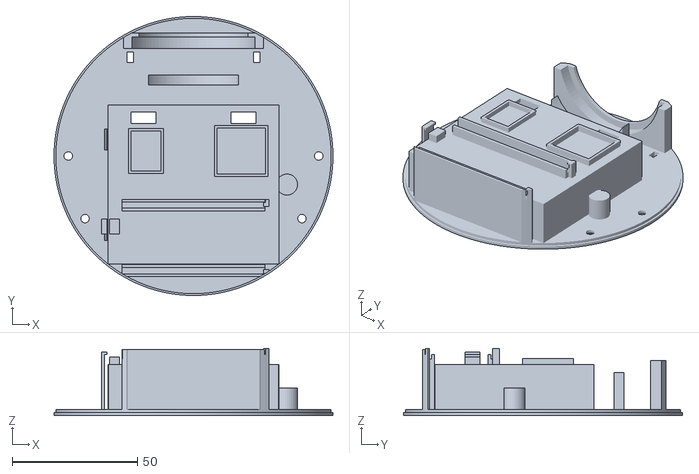
[picture p46: CAD file, 2026-11-10]
cad/stl_cakil/renkli_bambu/2_taban_plakasi_1_beyaz.stl
111.4 x 111.4 x 26.8
