yusuf7855/hikaye-oyuncak/cad/stl/difuzor_halka.stl

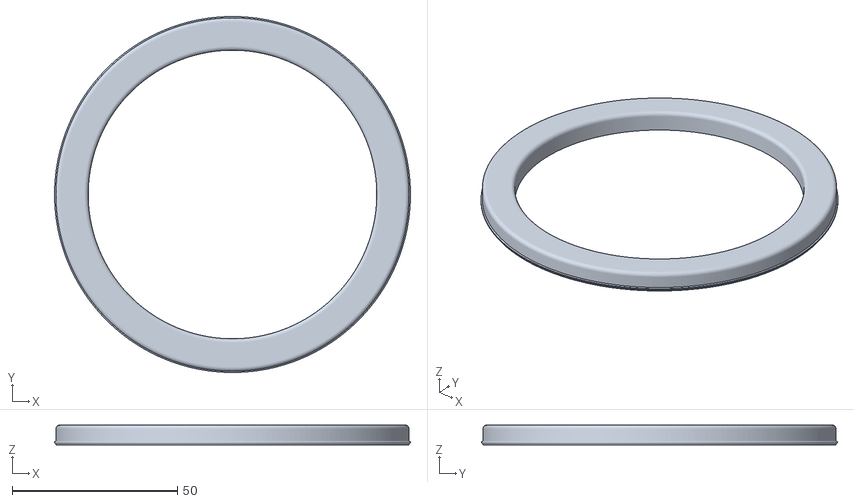
[picture p47: CAD file, 2026-11-10]
cad/stl/difuzor_halka.stl
107.6 x 107.6 x 6.00
