yusuf7855/hikaye-oyuncak/cad/stl_cakil/figurler/20_bilge_baykus.stl

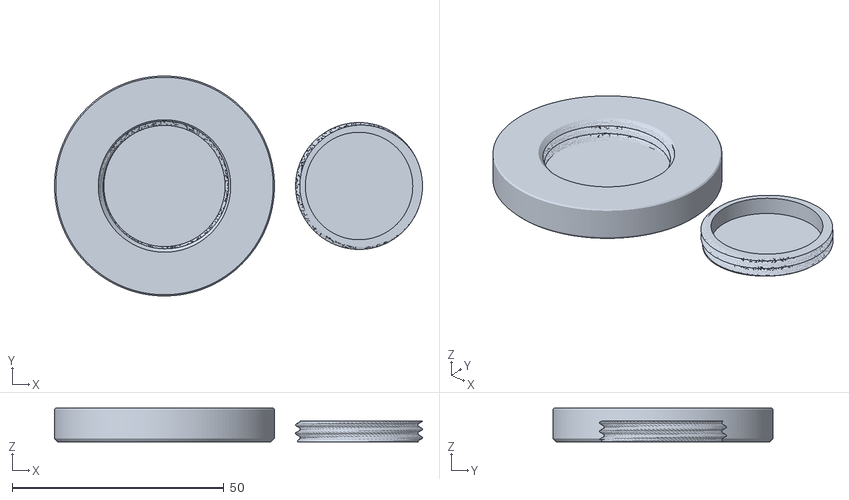
[picture p48: CAD file, 2026-11-10]
cad/stl_cakil/figurler/20_bilge_baykus.stl
87.0 x 52.0 x 8.00
