yusuf7855/hikaye-oyuncak/cad/stl_cakil/pn5180/5_ayar_karti.stl

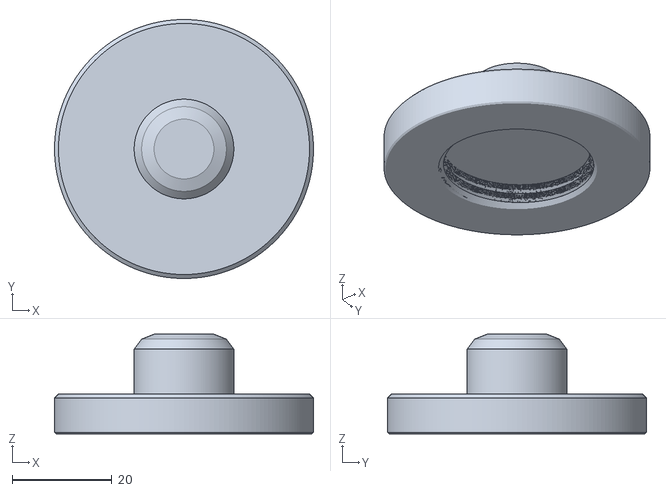
[picture p49: CAD file, 2026-11-10]
cad/stl_cakil/pn5180/5_ayar_karti.stl
52.0 x 52.0 x 20.0
