yusuf7855/hikaye-oyuncak/cad/stl_cakil/renkli_bambu/3_halka_nfc_tutucu_rc522_2_turkuaz.stl

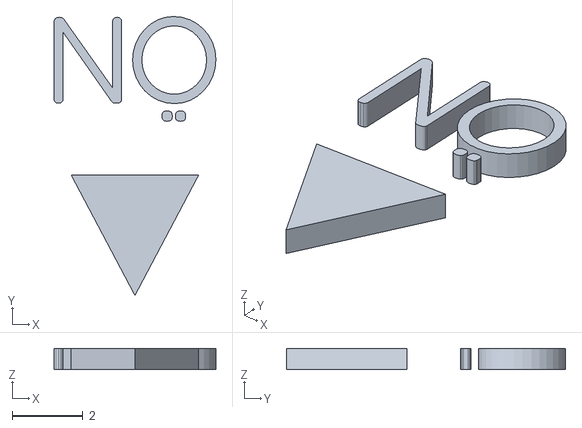
[picture p50: CAD file, 2026-11-10]
cad/stl_cakil/renkli_bambu/3_halka_nfc_tutucu_rc522_2_turkuaz.stl
4.57 x 7.88 x 0.6
