yusuf7855/hikaye-oyuncak/cad/stl/ayar_karti.stl

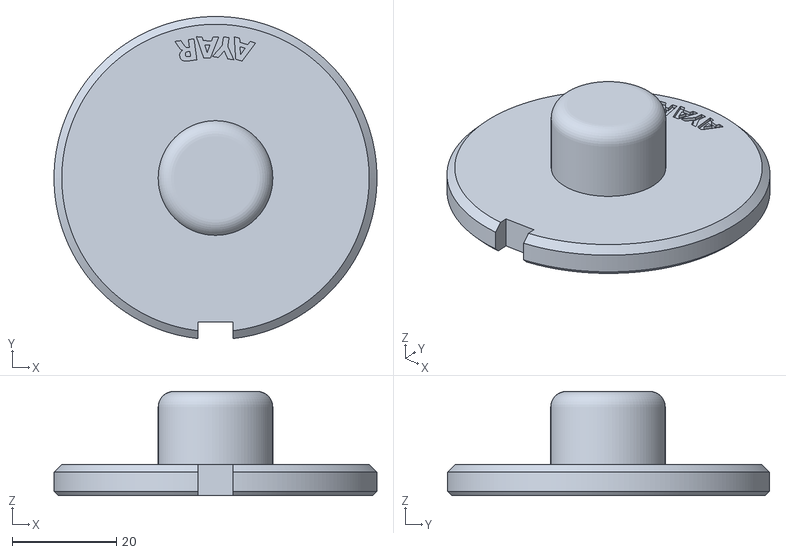
[picture p51: CAD file, 2026-11-10]
cad/stl/ayar_karti.stl
62.0 x 61.8 x 20.0
