yusuf7855/hikaye-oyuncak/cad/stl/figurler/ejderha_yavrusu.stl

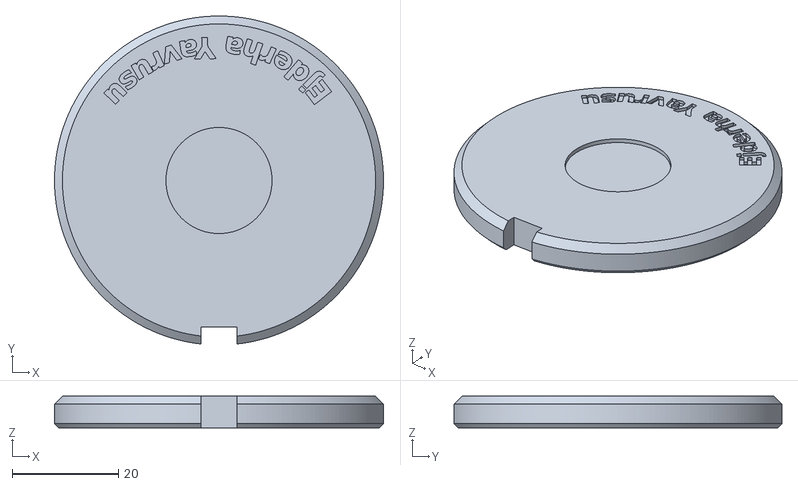
[picture p52: CAD file, 2026-11-10]
cad/stl/figurler/ejderha_yavrusu.stl
62.0 x 61.8 x 6.00
