yusuf7855/hikaye-oyuncak/cad/stl_cakil/pn5180/1_kabuk_kulaksiz.stl

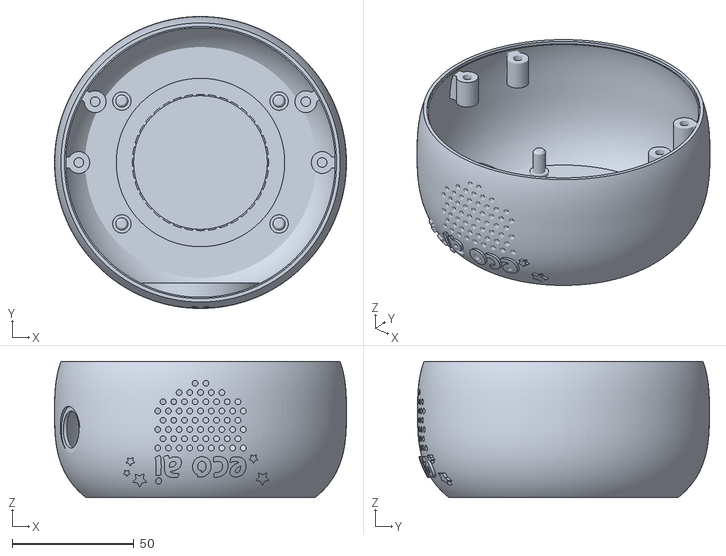
[picture p53: CAD file, 2026-11-10]
cad/stl_cakil/pn5180/1_kabuk_kulaksiz.stl
120.0 x 120.0 x 56.0
