yusuf7855/hikaye-oyuncak/cad/stl/govde_alt.stl

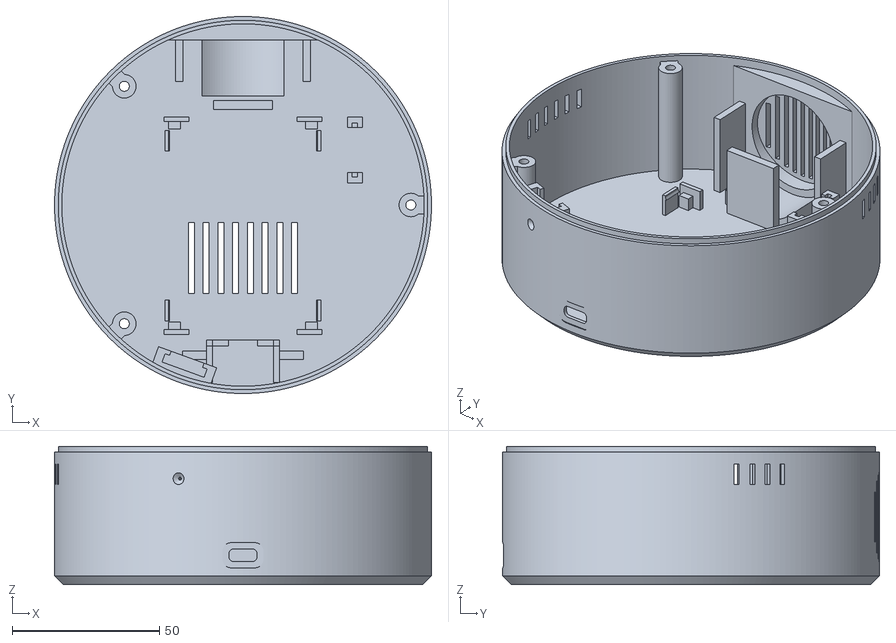
[picture p54: CAD file, 2026-11-10]
cad/stl/govde_alt.stl
128.0 x 128.0 x 47.0
