yusuf7855/hikaye-oyuncak/cad/stl_cakil/pn5180/4_figur_taban.stl

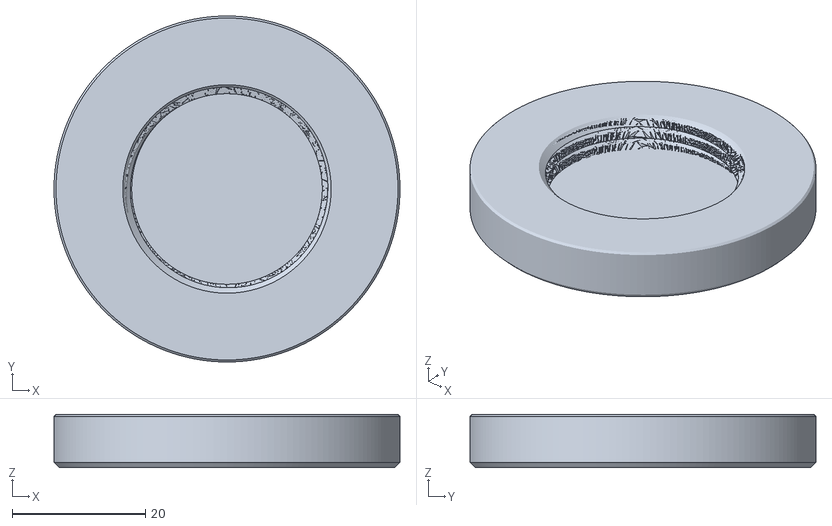
[picture p55: CAD file, 2026-11-10]
cad/stl_cakil/pn5180/4_figur_taban.stl
52.0 x 52.0 x 8.00
