yusuf7855/hikaye-oyuncak/cad/stl_cakil/renkli_bambu/1_kabuk_kulaksiz.3mf

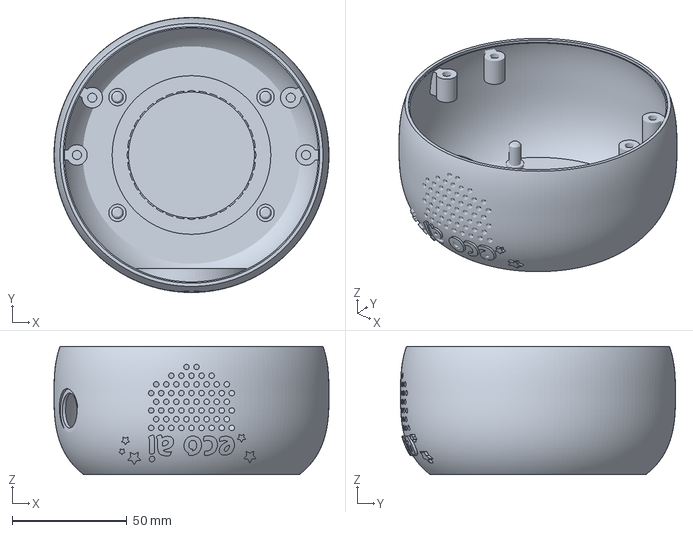
[picture p56: CAD file, 2026-11-10]
cad/stl_cakil/renkli_bambu/1_kabuk_kulaksiz.3mf
120.0 x 120.0 x 56.0 mm
