yusuf7855/hikaye-oyuncak/cad/stl_cakil/renkli_bambu/1_kabuk_kulaksiz_2_turkuaz.stl

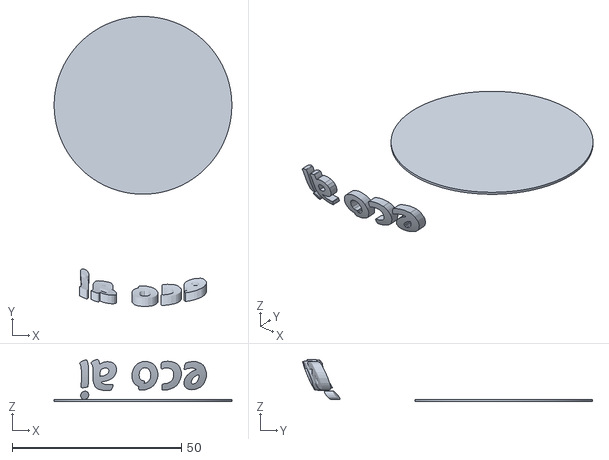
[picture p57: CAD file, 2026-11-10]
cad/stl_cakil/renkli_bambu/1_kabuk_kulaksiz_2_turkuaz.stl
52.5 x 85.7 x 12.4
