yusuf7855/hikaye-oyuncak/cad/stl_cakil/renkli_bambu/5_ayar_karti_3_sari.stl

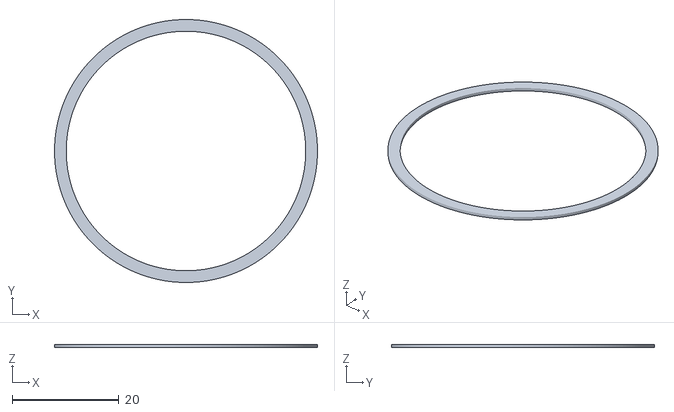
[picture p58: CAD file, 2026-11-10]
cad/stl_cakil/renkli_bambu/5_ayar_karti_3_sari.stl
49.2 x 49.2 x 0.6
