yusuf7855/hikaye-oyuncak/cad/stl_cakil/renkli_bambu/5_ayar_karti_1_beyaz.stl

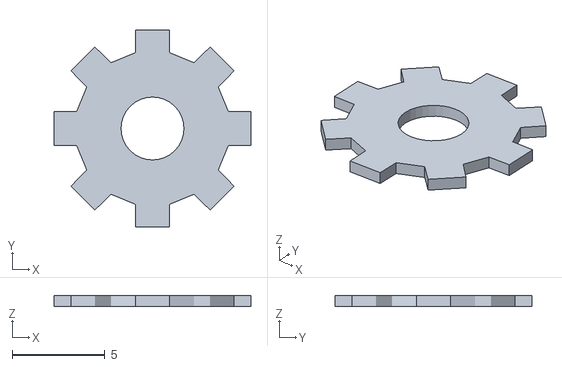
[picture p59: CAD file, 2026-11-10]
cad/stl_cakil/renkli_bambu/5_ayar_karti_1_beyaz.stl
10.6 x 10.6 x 0.6
