yusuf7855/hikaye-oyuncak/cad/stl_cakil/renkli_bambu/3_halka_nfc_tutucu_pn5180_1_beyaz.stl

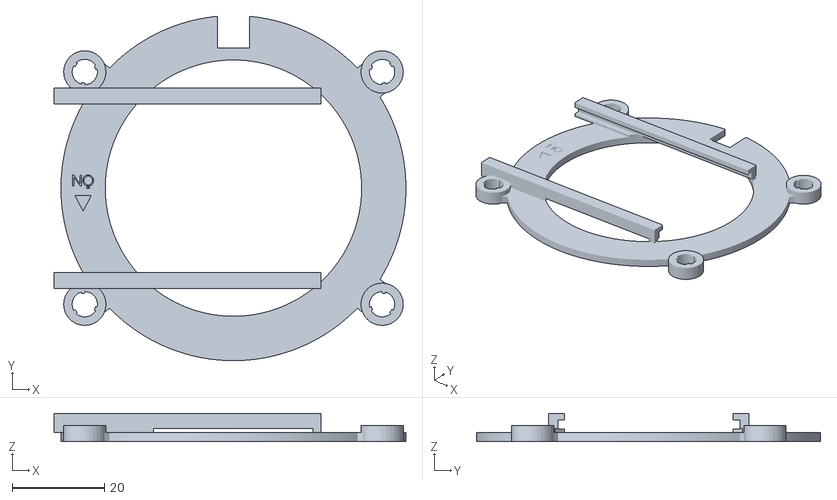
[picture p60: CAD file, 2026-11-10]
cad/stl_cakil/renkli_bambu/3_halka_nfc_tutucu_pn5180_1_beyaz.stl
76.5 x 74.8 x 6.10
