yusuf7855/hikaye-oyuncak/cad/stl_cakil/renkli_bambu/2b_pil_kapagi_2_turkuaz.stl

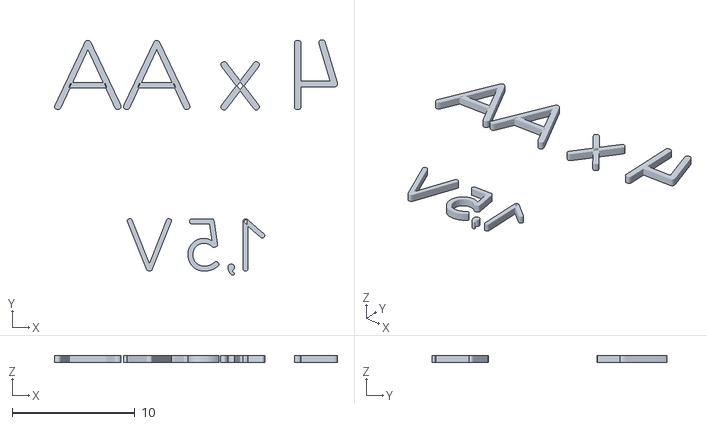
[picture p61: CAD file, 2026-11-10]
cad/stl_cakil/renkli_bambu/2b_pil_kapagi_2_turkuaz.stl
23.0 x 19.2 x 0.6
