yusuf7855/hikaye-oyuncak/cad/stl_cakil/renkli_bambu/1_kabuk_kulaksiz_4_mor.stl

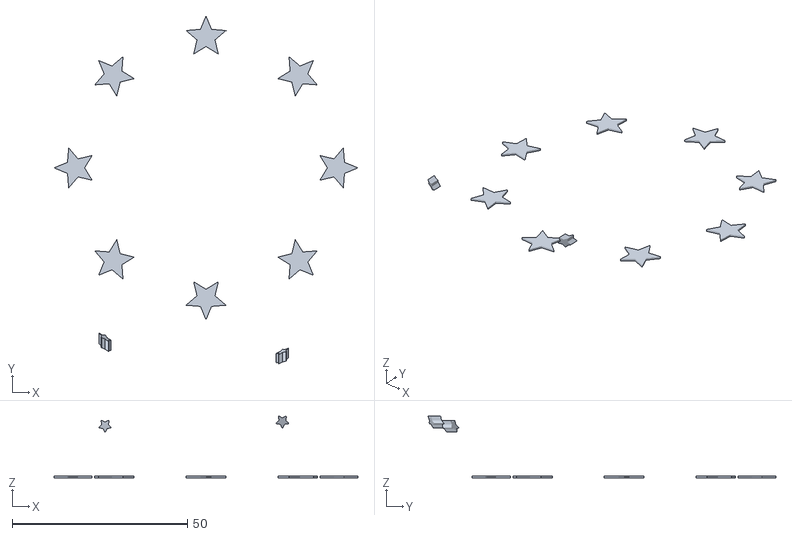
[picture p62: CAD file, 2026-11-10]
cad/stl_cakil/renkli_bambu/1_kabuk_kulaksiz_4_mor.stl
86.7 x 99.3 x 17.6
