yusuf7855/hikaye-oyuncak/cad/stl_cakil/renkli_bambu/2_taban_plakasi_2_turkuaz.stl

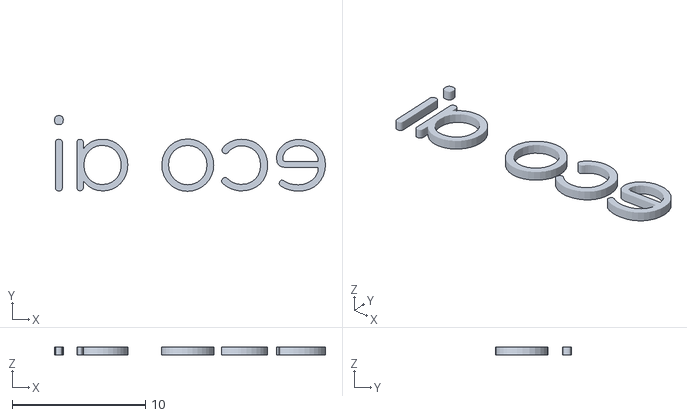
[picture p63: CAD file, 2026-11-10]
cad/stl_cakil/renkli_bambu/2_taban_plakasi_2_turkuaz.stl
20.3 x 5.68 x 0.6
