yusuf7855/hikaye-oyuncak/cad/stl_cakil/renkli_bambu/2b_pil_kapagi.3mf

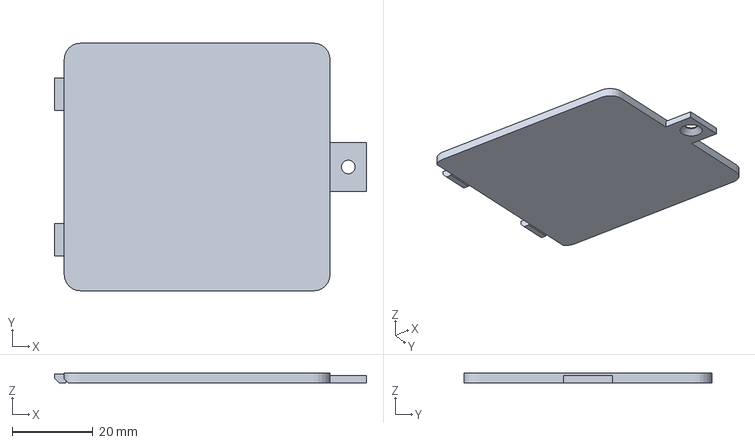
[picture p64: CAD file, 2026-11-10]
cad/stl_cakil/renkli_bambu/2b_pil_kapagi.3mf
77.1 x 61.2 x 2.40 mm
