yusuf7855/hikaye-oyuncak/(list of files, cad)

Other CAD files:
cad/stl_cakil/renkli_bambu/3_halka_nfc_tutucu_rc522.3mf
cad/stl/figurler/fistik.stl
cad/stl_cakil/figurler/18_zipzip.stl
cad/step_cakil/taban_plakasi.step
cad/stl/figurler/bip.stl
cad/stl_cakil/rc522/3_halka_nfc_tutucu.stl
cad/stl_cakil/figurler/16_nasreddin_hoca.stl
cad/stl_cakil/renkli_bambu/1_kabuk_kulaksiz_1_beyaz.stl
cad/stl/figurler/gece.stl
cad/stl_cakil/figurler/13_pamuk_prenses.stl
cad/stl/figurler/tontis.stl
cad/stl_cakil/figurler/bos_figur_taban.stl
cad/stl_cakil/renkli_bambu/3_halka_nfc_tutucu_pn5180_2_turkuaz.stl
cad/stl/figurler/pinokyo.stl
cad/stl_cakil/figurler/04_keloglan.stl
cad/stl_cakil/figurler/19_tontis.stl
cad/stl_cakil/renkli_bambu/3_halka_nfc_tutucu_pn5180.3mf
cad/stl_cakil/renkli_bambu/2b_pil_kapagi_1_beyaz.stl
cad/stl_cakil/renkli_bambu/2_taban_plakasi.3mf
