yusuf7855/hikaye-oyuncak/cad/patlatilmis_montaj.pdf

## PATLATILMIŞ MONTAJ (kesit A–A, x = 0; sol = arka, sağ = ön) ölçek 1:1

## MONTAJ SIRASI

1 Alt gövdeye 3 silikon ayak; USB-C kartını platforma epoksiyle yapıştır, kabloyu kablo bağıyla sabitle.

2 Hoparlörü (1 mm köpük conta ile) üstten ön bölmeye kaydır, arkaya 3 mm köpük; 4 nokta silikon.

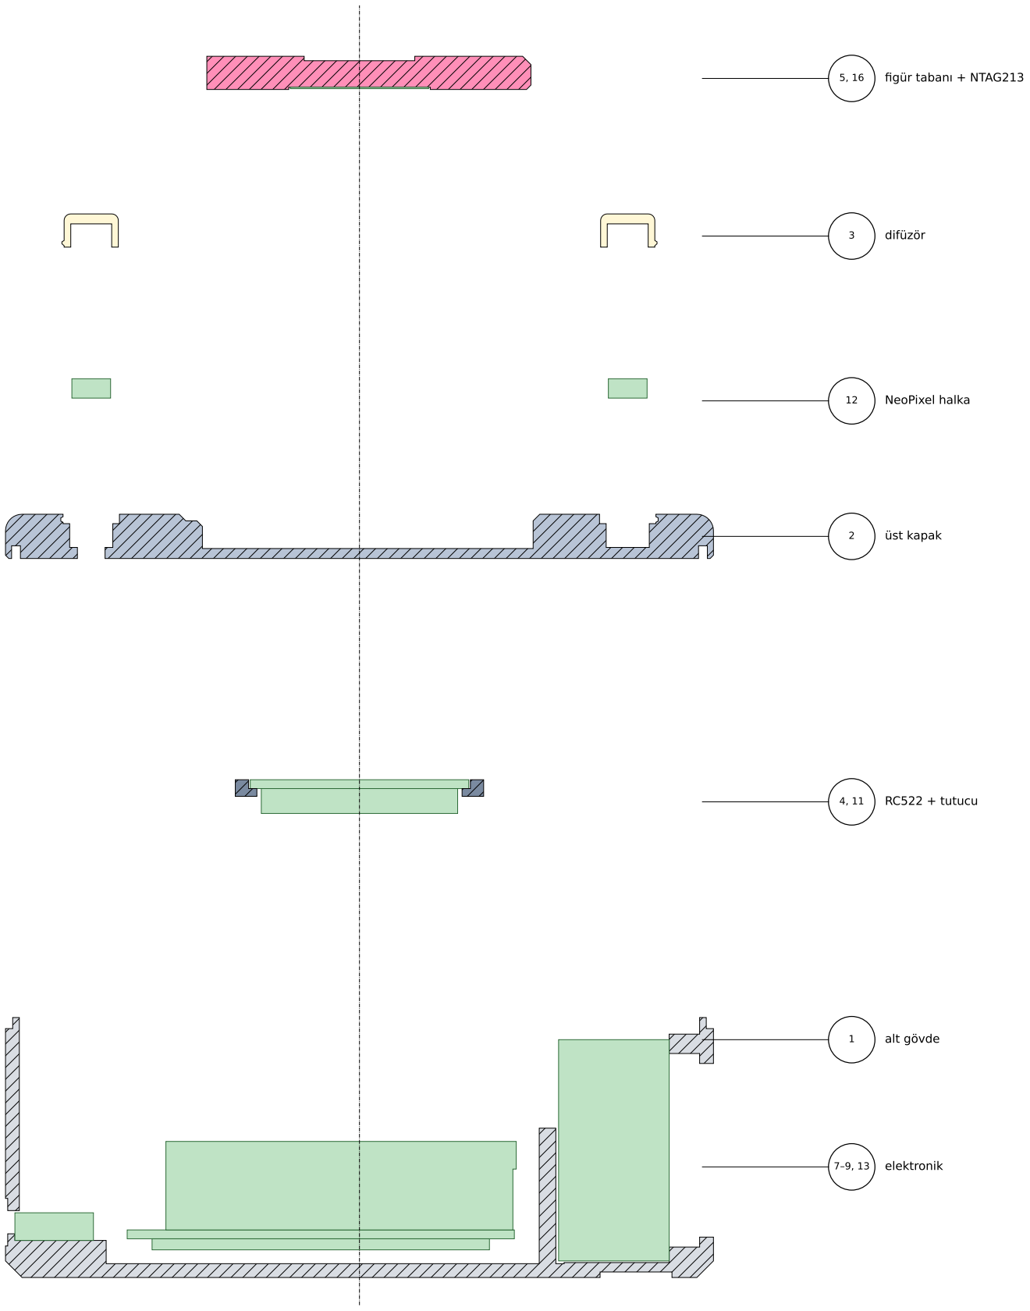
[picture p65: figure]
alt gövde; elektronik; RC522 + tutucu; üst kapak; NeoPixel halka; difüzör; figür tabanı + NTAG213

3 MAX98357A'yı dikey kızağa üstten kaydır (klemens aşağıda, hoparlör kablosu bağlı).

4 INMP441'i conta + kart olarak arka pede üstten kaydır (delikli yüz duvara).

5 Taşıyıcı pertinaksı 4 köşe kenetine bastır; DevKit'i dişi headerlara tak.

6 Kapağın 3 deliğine M3 ısıl gömme somunları havya ile göm (230 °C).

7 RC522'yi (bileşen yüzü aşağı) tutucuya koy, tutucuyu 4×M2,5x8 ile kapağa vidala.

8 Halkayı kanala koy (kablo arkadaki yarıktan aşağı), 1000 µF + 330 Ω halka ucunda.

9 Difüzörü bastır (tırnak oturur; kalıcı için 3 nokta şeffaf silikon).

10 Kabloları tak, testleri yap (docs/DONANIM.md), kapağı dil–oluk ile oturt,

alttan 3×M3x10 ile vidala. Figür tabanlarına NTAG213 yapıştır, figürleri üste yapıştır.

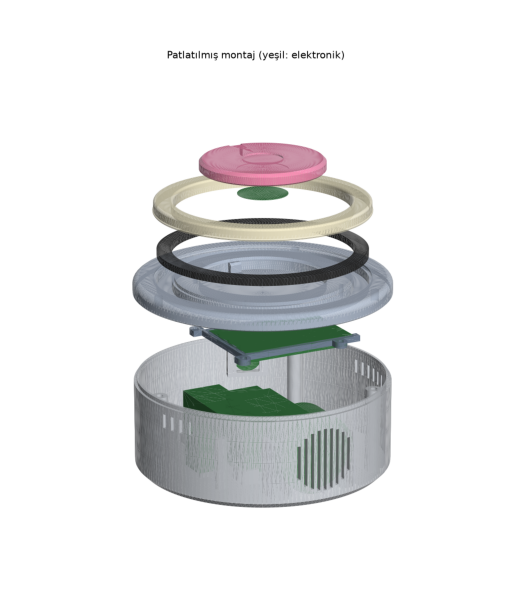
[picture p66: figure]

# MASAL STANDI — patlatılmış montaj

A3 · ölçek 1:1 · balon numaraları = teknik çizim parça listesi · sayfa 2/2
