yusuf7855/hikaye-oyuncak/cad/onizleme/montaj_iki_modul.png

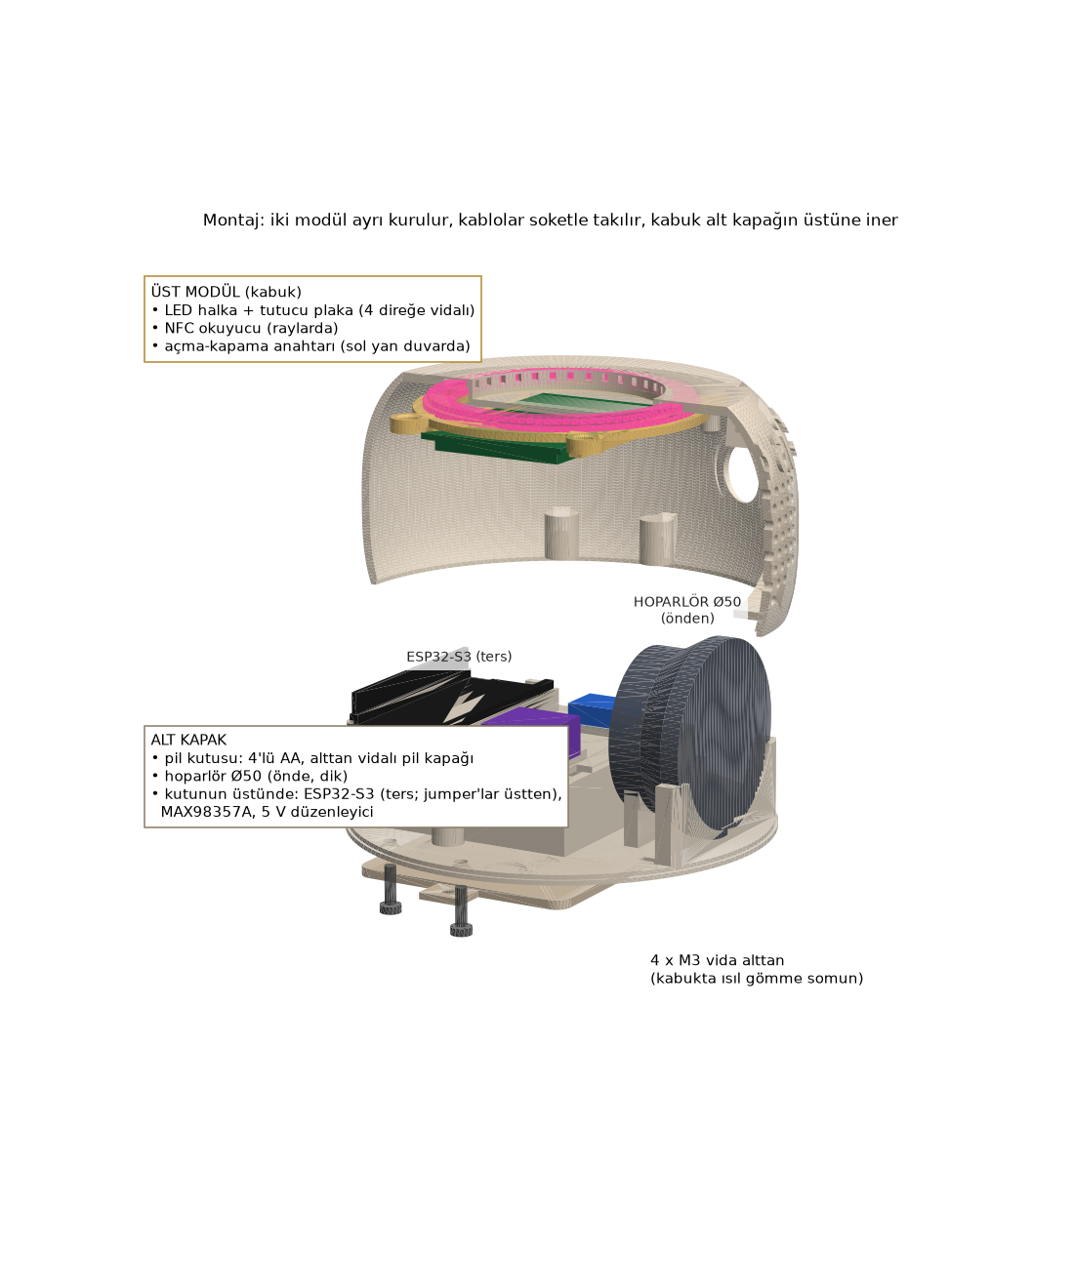
cad/onizleme/montaj_iki_modul.png
