yusuf7855/hikaye-oyuncak/cad/onizleme/montaj_izometrik.png

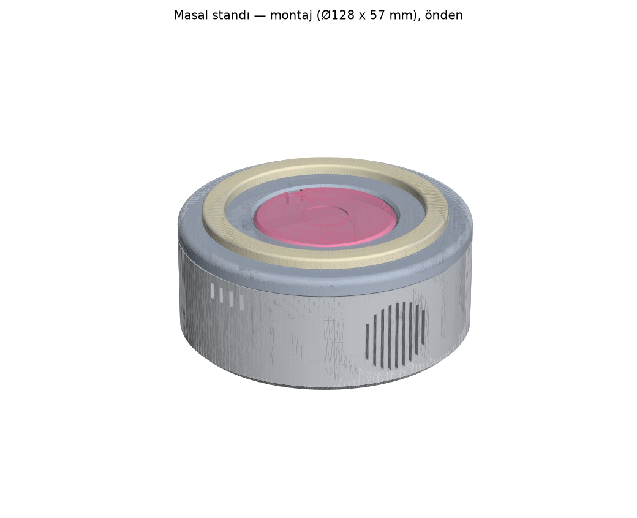
cad/onizleme/montaj_izometrik.png
