yusuf7855/hikaye-oyuncak/firmware/hikaye_oyuncak/tools/kuyruk_test.py

"""Hikâye kuyruğunun ve ürün davranışının kartın kendi koduyla (hikaye_oyuncak.ino, sahte ESP32 başlıklarıyla:
tools/kart_pc) bilgisayarda denemesi. Kuyruk bölümü bir dosyada durur (KART_KUYRUK): kart_pc'yi yeniden çalıştırmak
kartı yeniden başlatmaktır.

  1. doldur:   bölüm eski model baytlarıyla (çöp) dolu; boşta arka plan üretimi her figüre KUYRUK_FIGUR_BASI hikâye
               yazar. Her işte K aday üretilir, yazılan = en yüksek puanlı aday (eşitlikte ilki), token token.
               --urun: ilk iki iş degerlendirme/urun_uret.py ile de üretilir; seçilen hikâye aynı olmalı.
  2. çal:      yeniden başlat; "2" Pamuk Prenses'in en eski hazır hikâyesini hiç üretmeden çalar, tüketir; "2 1" yer
               seçerek.
  3. kalıcı:   yeniden başlat; tüketilenler tüketilmiş kalır; boşta yalnız eksikler yeniden üretilir.
  4. bozulma:  dosyada bir hikâyenin bir baytı bozulur: o yuva açılışta yok sayılır ve yeniden üretilir.
  5. kesme:    arka plan üretimi sürerken oyuncak standa konur: aday bırakılır, oyuncak selamlanır, hikâyesi okunur,
               iş kaldığı yerden sürer; canlı üretim oyuncak çekilince durur.
  (Stand, sesli komut, halka, ayar modu, gece figürü: tools/urun_akis_test.py. Düğmeler yalnız geliştirmede:
  tools/dugme_test.c.)

Kullanım: .venv/bin/python firmware/hikaye_oyuncak/tools/kuyruk_test.py [--K 3] [--basi 2] [--urun]
Model: HIKAYE_MODEL ortam değişkeni (model.bin + tokenizer.json dizini); yoksa ürün modeli modeller/c3ft_urun13,
o da yoksa modeller/c3ft_karma. Figürler ve yer sayıları generated/istemler.h'den (kartın derlendiği tablolar).
Çıkış kodu: hata varsa 1.
"""
import argparse
import os
import random
import re
import shutil
import struct
import subprocess
import sys
import tempfile

TOOLS = os.path.dirname(os.path.abspath(__file__))
SKETCH = os.path.dirname(TOOLS)
ROOT = os.path.dirname(os.path.dirname(SKETCH))
MODEL = os.environ.get("HIKAYE_MODEL") or next(
    (m for m in (os.path.join(ROOT, "modeller", "c3ft_urun13"), os.path.join(ROOT, "modeller", "c3ft_karma"))
     if os.path.exists(os.path.join(m, "model.bin"))), os.path.join(ROOT, "modeller", "c3ft_urun13"))
KUYRUK_OFS, KUYRUK_BOYUT, SEKTOR = 0xFE0000, 0x20000, 4096


def istemler_tablosu():
    """generated/istemler.h: N_FIGUR, FIGUR_YER_N ve FIGUR_AD (kartın derlendiği ürün figürleri)."""
    s = open(os.path.join(SKETCH, "generated", "istemler.h"), encoding="utf-8").read()
    n = int(re.search(r"#define N_FIGUR (\d+)", s).group(1))
    yer_n = [int(x) for x in re.search(r"FIGUR_YER_N\[\d+\] = \{([^}]*)\}", s).group(1).replace(",", " ").split()]
    govde = re.search(r"FIGUR_AD\[\d+\] = \{(.*?)\};", s, re.S).group(1).replace('" "', "")  # bitişik dizgeler
    ad = [a.encode("latin-1").decode("unicode_escape").encode("latin-1").decode("utf-8")
          for a in re.findall(r'"((?:[^"\\]|\\.)*)"', govde)]
    assert len(yer_n) == n, (n, yer_n)
    return n, yer_n, ad


N_FIGUR, YER_N, FIGUR_AD = istemler_tablosu()
FE = 1  # denemelerde öne çıkan figür: istemler.h'de 2. figür (Pamuk Prenses), seri komut "2"

hatalar = []


def dene(kosul, mesaj):
    if not kosul:
        hatalar.append(mesaj)
        print("  HATA:", mesaj)
    return kosul


def derle(d, K, basi):
    kart = os.path.join(d, "kart_pc")
    subprocess.run([os.environ.get("CXX", "g++"), "-O2", "-Wall", "-Wno-unused-function", f"-DKUYRUK_K={K}",
                    f"-DKUYRUK_FIGUR_MAKS={basi}", "-I" + os.path.join(TOOLS, "kart_pc", "sahte"), "-o", kart,
                    os.path.join(TOOLS, "kart_pc", "kart_pc.cpp")], check=True)
    return kart


def kos(kart, d, satirlar, ses=None, ek_env=None):
    env = dict(os.environ, KART_MODEL=os.path.join(MODEL, "model.bin"),
               KART_BOLUMLER=os.path.join(SKETCH, "partitions.csv"),
               KART_KUYRUK=os.path.join(d, "kuyruk.bin"), KART_NVS=os.path.join(d, "nvs.txt"))
    if ses:
        env["KART_SES"] = ses
    env.update(ek_env or {})
    r = subprocess.run([kart], input="".join(s + "\n" for s in satirlar), capture_output=True, text=True, env=env)
    if r.returncode:
        print(r.stdout[-3000:], r.stderr[-3000:])
        raise SystemExit(f"kart_pc çıkış kodu {r.returncode}")
    return r.stdout, r.stderr.splitlines()


def ayikla(err):
    """stderr satırları -> olay listesi: ("ADAY", j, puan, tok) | ("KUYRUK", y, f, j, K, puan, n_plan, tok) |
    ("CALINDI", f, j, tok) | ("DURUM", hazır, yuva, uyku, bekçi, silme) | ("UYKU", ms) | ("BOSTA", n)"""
    olay = []
    for s in err:
        p = s.split()
        if not p:
            continue
        if p[0] == "ADAY":
            olay.append(("ADAY", int(p[1]), float(p[7]), [int(x) for x in p[8:]], int(p[3]), p[5] == "1"))
        elif p[0] == "KUYRUK":
            olay.append(("KUYRUK", int(p[1]), int(p[2]), int(p[3]), int(p[4]), float(p[5]), int(p[7]),
                         [int(x) for x in p[8:]]))
        elif p[0] == "CALINDI":
            olay.append(("CALINDI", int(p[1]), int(p[2]), [int(x) for x in p[4:]]))
        elif p[0] == "DURUM":
            olay.append(("DURUM",) + tuple(int(x) for x in p[1:]))
        elif p[0] == "UYKU":
            olay.append(("UYKU", int(p[1]), "GPIO" in s))
        elif p[0] == "BOSTA":
            olay.append(("BOSTA", int(p[1])))
    return olay


def f32(x):
    return struct.unpack("<f", struct.pack("<f", x))[0]


def isler(olay, K):
    """ADAY ... KUYRUK gruplarını çıkarır ve her işte yazılanın en iyi aday olduğunu denetler."""
    out, aday = [], []
    for o in olay:
        if o[0] == "ADAY":
            aday.append(o)
        elif o[0] == "KUYRUK":
            _, y, f, j, k, puan, n_plan, tok = o
            dene(y >= 0, f"kuyruğa yazılamadı ({f} {j})")
            son = aday[-K:]
            dene([a[1] for a in son] == list(range(K)), f"iş ({f},{j}): aday sırası {[a[1] for a in son]}")
            en = max(range(len(son)), key=lambda i: (son[i][2], -i))
            dene(son[en][3] == tok and f32(son[en][2]) == puan and son[en][4] == n_plan,
                 f"iş ({f},{j}): yazılan en iyi aday değil")
            dene(k == K, f"iş ({f},{j}): K={k}")
            out.append({"y": y, "f": f, "j": j, "puan": puan, "tok": tok, "adaylar": son})
            aday = []
    return out


def durum(olay):
    d = [o for o in olay if o[0] == "DURUM"]
    return [x[1] for x in d]


def urun_karsilastir(d, isler_, tohum, K):
    """İlk işleri urun_uret ile üretir (gen.c -DLLM_INT8_ACT; tools/kart_pc_karsilastir.py ile aynı yol)."""
    gen_i8 = os.path.join(d, "gen_i8")
    subprocess.run([os.environ.get("CC", "cc"), "-O3", "-DLLM_INT8_ACT", "-o", gen_i8,
                    os.path.join(ROOT, "runtime", "host_verify", "gen.c"), "-lm"], check=True)
    os.environ["GEN"] = gen_i8
    sys.path.insert(0, os.path.join(ROOT, "degerlendirme"))
    import urun_uret as U
    from tokenizers import Tokenizer
    tok = Tokenizer.from_file(os.path.join(MODEL, "tokenizer.json"))
    os.makedirs(os.path.join(d, "suzgec"), exist_ok=True)
    for i in isler_:
        fig = U.FIGURLER[i["f"]]
        k = U.KARTLAR[fig]
        yer = k["yerler"][i["j"]]["etiket"]
        suz = U.suzgec_dosyasi(tok, U.kadro_disi(fig), os.path.join(d, "suzgec", fig + ".txt"))
        ids = U.istem(tok, k["ad"]["deger"], yer, None)
        py = []
        for jj in range(K):
            c = U.aday_uret(MODEL, tok, ids, tohum + jj, 0.5, suz)
            c["puan"], _ = U.puanla(c, fig, yer)
            py.append(c)
        en = max(range(K), key=lambda x: py[x]["puan"])
        t = i["tok"]
        n_plan = [a for a in i["adaylar"] if a[3] == t][0][4]
        plan = ("Sorun:" + tok.decode(t[:n_plan - 2])).strip()
        metin = tok.decode(t[n_plan:]).strip()
        ok = dene(plan == py[en]["plan"] and metin == py[en]["metin"] and abs(py[en]["puan"] - i["puan"]) < 1e-5,
                  f"urun_uret farkı: {fig} {yer}")
        print(f"  urun_uret: {fig} {yer} K={K}: seçilen aday {en}, puan {py[en]['puan']:.4f} -> "
              f"{'aynı' if ok else 'FARKLI'}")


def main():
    ap = argparse.ArgumentParser()
    ap.add_argument("--K", type=int, default=3, help="kuyruk aday sayısı (ürün 16; deneme hızlı olsun diye 3)")
    ap.add_argument("--basi", type=int, default=2, help="figür başına hazır hikâye (ürün 3)")
    ap.add_argument("--urun", action="store_true", help="ilk iki işi urun_uret.py ile karşılaştır")
    ap.add_argument("--dizin")
    a = ap.parse_args()
    d = a.dizin or tempfile.mkdtemp(prefix="kuyruk_test_")
    os.makedirs(d, exist_ok=True)
    K, B = a.K, a.basi
    kart = derle(d, K, B)
    toplam = N_FIGUR * B

    print(f"1. doldur (K={K}, figür başına {B}; bölüm çöp dolu)")
    random.seed(3)
    with open(os.path.join(d, "kuyruk.bin"), "wb") as f:
        f.write(bytes(random.getrandbits(8) for _ in range(KUYRUK_BOYUT)))
    if os.path.exists(os.path.join(d, "nvs.txt")):
        os.remove(os.path.join(d, "nvs.txt"))
    out, err = kos(kart, d, ["#tohum 100", "#durum", "sahip hepsi", "#bosta", "#durum", "k"])
    olay = ayikla(err)
    ii = isler(olay, K)
    dene(durum(olay) == [0, toplam], f"hazır sayısı {durum(olay)}, beklenen [0, {toplam}]")
    dene(len(ii) == toplam, f"{len(ii)} iş")
    for f in range(N_FIGUR):
        yerler = [i["j"] for i in ii if i["f"] == f]
        dene(len(yerler) == B and len(set(yerler)) == min(B, YER_N[f]), f"figür {f}: yerler {yerler}")
    dene(len({i["y"] for i in ii}) == toplam, "yuvalar tekrar etti")
    print(f"  {len(ii)} hikâye yazıldı, her biri {K} adayın en iyisi")
    if a.urun:
        urun_karsilastir(d, ii[:2], 100, K)

    print("2. yeniden başlat, çal")
    fe_ad = FIGUR_AD[FE]
    fe = [i for i in ii if i["f"] == FE]  # yazılış sırası = sıra
    beklenen = fe[0]
    kalan = fe[1:]
    yer0 = [i for i in kalan if i["j"] == 0]
    out, err = kos(kart, d, ["#durum", f"{FE + 1}", f"{FE + 1} 1", "#durum"])
    olay = ayikla(err)
    cal = [o for o in olay if o[0] == "CALINDI"]
    ilk_aday = next((k for k, o in enumerate(olay) if o[0] == "ADAY"), len(olay))
    ilk_cal = next((k for k, o in enumerate(olay) if o[0] == "CALINDI"), len(olay))
    dene(ilk_cal < ilk_aday, f"\"{FE + 1}\" hazır hikâyeyi üretmeden önce çalmadı")
    dene(cal and cal[0][1] == FE and cal[0][3] == beklenen["tok"], f"\"{FE + 1}\": {fe_ad} en eski hikâyesi çalınmadı")
    dene("hazır hikâye" in out, "çıktıda 'hazır hikâye' yok")
    tuketilen = 1
    if yer0:
        dene(len(cal) == 2 and cal[1][2] == 0 and cal[1][3] == yer0[0]["tok"], f"\"{FE + 1} 1\": {fe_ad} 1. yer hazırı çalınmadı")
        tuketilen = 2
    else:
        dene(len(cal) == 1 and "canlı okuma (yazdıkça)" in out, f"\"{FE + 1} 1\": hazır yokken canlı okunmadı")
    dene(durum(olay) == [toplam, toplam - tuketilen], f"hazır sayısı {durum(olay)}")
    print(f"  {tuketilen} hazır hikâye çalındı (üretim beklemeden)")

    print("3. yeniden başlat: tüketilenler kalıcı, eksikler yeniden üretilir")
    out, err = kos(kart, d, ["#tohum 300", "#durum", "#bosta", "#durum"])
    olay = ayikla(err)
    yeni = isler(olay, K)
    dene(durum(olay) == [toplam - tuketilen, toplam], f"hazır sayısı {durum(olay)}")
    dene(len(yeni) == tuketilen and all(i["f"] == FE for i in yeni), f"yeniden üretilen {[(i['f'], i['j']) for i in yeni]}")
    print(f"  {len(yeni)} hikâye yeniden üretildi ({fe_ad})")

    print("4. bozulma: bir hikâyenin bir baytı bozuldu")
    with open(os.path.join(d, "kuyruk.bin"), "r+b") as f:
        hedef = ii[3]
        f.seek(hedef["y"] * SEKTOR + 32 + 7)
        b = f.read(1)
        f.seek(hedef["y"] * SEKTOR + 32 + 7)
        f.write(bytes([b[0] ^ 0x10]))
    out, err = kos(kart, d, ["#tohum 400", "#durum", "#bosta", "#durum"])
    olay = ayikla(err)
    yeni = isler(olay, K)
    dene(durum(olay) == [toplam - 1, toplam], f"hazır sayısı {durum(olay)}")
    dene(len(yeni) == 1 and yeni[0]["f"] == hedef["f"], "bozulan yeniden üretilmedi")
    print(f"  bozuk yuva yok sayıldı ve yeniden üretildi (figür {hedef['f'] + 1})")

    print("5. kesme: arka plan üretimi sürerken oyuncak kondu; canlı üretim sürerken oyuncak çekildi")
    os.remove(os.path.join(d, "kuyruk.bin"))
    # ARKA_BEKLE_MS (5 s, sahte saat) sonra iş başlar; etiket ondan ~1,2 s sonra konur (gerçek saat: aday ortası)
    # nfc_no 4 = Keloğlan (data/figur_donanim.json)
    out, err = kos(kart, d, ["k+", "sahip yok", "sahip +4", "#tohum 500", "#sonra 6200 #etiket koy 4", "#bosta 1",
                             "#durum"])
    olay = ayikla(err)
    ii6 = isler(olay, K)
    dene("[oyuncak: Keloğlan]" in out and "Keloğlan'ın hikâyesini" in out, "arka planda konan oyuncak selamlanmadı")
    dene("yarım kuyruk işinden" in out or "=== Keloğlan" in out, "oyuncak konunca hikâye yok")
    dene(len(ii6) == 1, "iş sürüp bitmedi")
    print(f"  arka plan: {'yarım işin en iyisi okundu' if 'yarım kuyruk işinden' in out else 'canlı'}; iş sonra tamamlandı")
    out, err = kos(kart, d, ["k-", "k sil", "sahip +14", "#etiket koy 14", "#sonra 4500 #etiket kaldir", "#bekle 20000",
                             "#durum"], ek_env={"KART_SAAT": "sahte"})  # 14 = Pinokyo
    dene("(durduruldu)" in out, "canlı üretim oyuncak çekilince durmadı")
    dene("(okuma:" not in out, "çekilen oyuncağın hikâyesi okundu")
    print("  canlı üretim durdu, hikâye okunmadı")

    print(f"\nkuyruk_test.py: {'HATA ' + str(len(hatalar)) if hatalar else 'hepsi geçti'} ({d})")
    if not a.dizin and not hatalar:
        shutil.rmtree(d, ignore_errors=True)
    sys.exit(1 if hatalar else 0)


if __name__ == "__main__":
    main()
