yusuf7855/hikaye-oyuncak/(commit log)

2026-09-24 Hikâye Oyuncağı: ESP32-S3 üzerinde offline Türkçe hikâye anlatan model
    - Türkçe TinyStories ile ön-eğitim (B 1.7M, C1 3.0M çekirdek), 16k tokenizer
    - 12 figür, sabit isimler; 2300+ oyuncak hikâyesi (v2, v3) + kontrol/kuyruk araçları
    - Eğitime devam/ilerleme dosyaları, --init-from, --qat-emb (4-bit uyumlu ince ayar)
    - Dışa aktarmada MSE-optimal kırpma; gen.c: tekrar cezası, yasak token listesi, log-olasılık
    - Hakem düzeni (rubrik, test seti, aday seçici), PC test arayüzü + NFC simülasyonu + Piper TTS
    - Detaylı README
2026-09-24 E0 ölçüm altyapısı: örnekleme bayrakları, olay örgüsü ölçüleri, hakem araçları
    - runtime/ornekle.h: gen.c'nin örneklemesi (top-k, tekrar cezası, yasaklar) ortak başlıkta;
    gen.c -P (başlık tekrar penceresine girmez), -N (gövdede satır sonu yasak), -e (EOT'de dur)
    - uret.py / otomatik.py: --baslik tema, --pencere govde, --satir-yasak, --eot-on; tüm adaylar
    adaylar_<ad>.json'a, ayar/istem özetiyle
    - tema_sinif.py (token Naive Bayes, doğrulamada %97.8), olay.py (iki yarı aynı tema, farklı tema,
    kopya8, çünkü, top), kosul_duyarlilik.py (doğru/yanlış tema ΔNLL, EOT öneki)
    - RUBRIK.md: S1-S3 olay örgüsü soruları; IKILI.md + ikili.py (kör ikili tercih)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
2026-09-24 docs: ESP32 bütçesi (model + kadın sesi + firmware kartta) ve olay örgüsü deney planı
    Claude-Session: https://claude.ai/code/session_013Uk1pnNsnDe3apokQAS6XA
2026-09-25 ESP32 bütçesi: C3 (çekirdek 5.7M, 4-bit PSRAM 7.1 MB, model.bin 10.3 MB), NFC ve BLE payı
    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
2026-09-25 Kart testi yazılımı (firmware/hikaye_oyuncak): figür/yer seçimi, plan modu, 4 aday + hafif seçici
    - Çekirdek int8 PSRAM'de, head 4-bit flash'ta, KV 224 konum: C2 PSRAM'e 5.8 MB ile sığar
    - Örnekleme runtime/ornekle.h (bilgisayardaki gen ile aynı); istemler ve yasaklı isimler generated/istemler.h
    - vocab.h bayt düzeyi tablodan (Türkçe harfler doğru); llm.h/ornekle.h çizime kopya (Arduino IDE)
    - Bilgisayarda sahte ESP32 başlıklarıyla derlenip v4 modeliyle denendi; Türkçe kurulum rehberi README.md
    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
    [partitions.csv]
2026-09-26 Firmware: head için hızlı 4-bit çekirdek, iki çekirdek, PSRAM; profil ve hız testi
    Kartta 1,6 token/s ölçüldü. Head (16384x160, 4-bit, flash) tek çekirdekte ve
    eleman başına nibble ayıklayan yoldan hesaplanıyordu. hiz.h: bayt bayt açan,
    -8'i grup başına düşen çekirdek (eski yolla bit bit aynı, tools/hiz_test.c),
    iki çekirdeğe bölme, kodların PSRAM'e kopyası. Her hikâyede token başına ms
    dökümü; 'b' komutu üç head yolunu ölçer. Ayrıca: struct Aday prototip hatası
    (Arduino) ve tek adayda plan bozulunca yeniden deneme.
    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
2026-09-26 Ses: Mac için tek komutluk eğitim betiği, sabit 25 bin cümle listesi, README
    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
    [metin.tsv]
2026-09-28 Ses: kart çıkarımı (taslak, yazılıyor)
    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
    [partitions.csv]
2026-09-28 Ses: kart çıkarımı tamam (ses.h, disa_aktar.py, I2S + yeşil LED, ses bölümü); bilgisayarda PyTorch ile ~1e-6 fark
    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
2026-09-29 Niloya kartı: 'keşfet' özelliğinde 'merak' biçimleri de kabul (kapı/hakem çelişkisi); kartlar yeniden kilitlendi
    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
2026-09-29 PC'de eş zamanlı üretim: parametreli iş akışı, kurulum belgesi, kapıların tokenizer dosyaları
    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
2026-09-29 Aşama 1 tamam: 11 figür ≥50 kabul (622); c3ft_urun eğitimi başladı
    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
2026-10-06 firmware: ürün modeli c3ft_karma + 11 figür, isim süzgeci, ürün seçicisi (PC'de urun_uret ile 328/328 aynı)
    - çekirdek PSRAM'de 4 bit (int8 sığmıyor): toplam ~7,25 MB; flash düzeni aynı, fp=00ea3e55
    - istemler/yasaklı adlar/seçici tabloları urun_uret'ten (basliklar.py); secici_urun_puanla = urun_uret.puanla (0 fark)
    - tools/kart_pc: çizimi sahte ESP32 başlıklarıyla PC'de derleyip gen ile karşılaştırma
    - modeller/c3ft_karma/model.bin depoya eklendi (ZIP ile yükleme için)
    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
2026-10-06 firmware: hikâye kuyruğu (flash'ta 48 yuva, boştayken 16 aday), düğmeler/LED, NFC arayüzü, uyku, ses düzeyi, watchdog
    - kuyruk bölümü 0xB80000 (model bölümünün kullanılmayan sonundan); model/ses adresleri aynı
    - PC'de urun_uret ile birebir (kart_pc_karsilastir 44/44), kuyruk/düğme C testleri, tests/test_kart_kuyruk.py
    - gerçek Arduino ESP32 çekirdeği 3.3.12 ile derlendi (USB-CDC, UART, RC522, PN532); kartta denenmedi
    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
    [partitions.csv]
2026-10-13 Ürün tanımı: Merhaba Eko, çocuk komutları, yalnız stand oyuncağı, NeoPixel halka, pin haritası; figür NFC numaraları ve renkleri
    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
2026-10-13 Stand donanımı ve 3B tasarım: DONANIM.md (parça listesi, kablolama, güç bütçesi, montaj, test), bağlantı/blok şeması, parametrik CAD (alt gövde, kapak, difüzör, RC522 tutucu, 12 figür tabanı, ayar ka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
2026-10-13 firmware: yalnız standdaki oyuncak, NFC etiket kaydı + oyuncak tanıtma, adla selamlama, ayar kartı (WPA2 SoftAP + ayar sayfası), NeoPixel halka, mikrofon + Merhaba Eko olayları, Ay Dede ninni modu
    - bölümler: uygulama 1,75 MB; model 0x1D0000'e taşındı (yeniden yüklenmeli), ses 0xBB0000 aynı, kuyruk 32 yuva
    - üretim urun_uret ile birebir (44/44); TTS varsayılanları birebir; pytest 17 geçti; gerçek Arduino çekirdeğiyle derlendi
    - kws.h / kws_model.h: uyandırma modeli ajanının ara sürümü (eğitim sürüyor)
    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
2026-10-15 Ay Dede: 100 anonim halk ninnisi (kaynaklı, uydurma yok)
    İlk 15 aynen; 85 yeni ninni ninni sayfaları, halk bilimi makaleleri ve bir doktora tezindeki derlemelerden
    (Çelebioğlu, Demir, Alaşehir/Tuzlukçu/Konya). Çocuğa uygun olmayan kıtalar çıkarıldı, oğlum/kızım -> yavrum.
    Her ninninin kaynağı ve yapılan değişiklik ninni_kaynaklar.tsv'de. yerlesik.h ≈12,5 KB metin.
    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
2026-10-15 Halka: NeoPixel 16'lı (Ø44,5 / Ø31,75 mm), HALKA_LED_SAYISI 16
    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
2026-10-15 CAD: dış görünüş konseptleri (çakıl, kubbe, pasta), 'eco ai' logosu, yarı saydam figür çanağı
    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
2026-10-15 CAD: çakıl formu + yükseltilmiş figür platformu (ışık bileziği / yüzen platform), gece görünüşü ve kesit
    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
2026-10-15 CAD: çakıl - 3. seçenek: çukurda figür yuvası + yarı saydam çanak ve ışık kenarı
    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
2026-10-15 CAD: çakıl stand iç yerleşimi (RC522 ve PN5180), çarpışma denetimi, STL'ler ve önizlemeler
    Kabuk (çukur figür yuvası, yarı saydam çanak, logo), taban plakası (hoparlör aşağı bakar, pil yatağı, TP4056
    kızağı, amfi tablası), ESP32 rafı, halka + NFC tutucu (iki okuyucu için). Ölçüler tahmin; denetim 0 sorun,
    etiket-anten ≈ 8,4 mm.
    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
2026-10-15 CAD: parçaları tek tek yerleştirme adımları (cakil_adim.py), adım 1: 16'lı halka
    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
2026-10-15 CAD: yarı saydam çanak kaldırıldı; figür zemini kabuğun parçası, LED'lerin üstünde 0,6 mm ışık oyuğu (her şey PLA/PETG)
    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
2026-10-15 CAD: halka tavana yaslanır, LED'ler zemindeki ışık oyuğuna girer (zemin 2,4 mm, oyuk 1,8 mm); etiket-anten ≈ 6,4 mm
    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
2026-10-15 CAD: seçenek A - halka çukurun çevresinde tavanda, çukur halkanın iç boşluğundan geçer (figür tabanı Ø28); etiket-anten ≈ 2,3 mm
    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
2026-10-15 CAD: LED'lerin üstü şerit şerit açık (32 ışınsal yarık, 1,2 mm); üstten gündüz/gece görünüşü
    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
2026-10-15 CAD: ışık yarıkları üstten kaldırıldı; çukurun dikey iç duvarında 24 pencere (ışık yandan çukura), üstte dudak
    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
2026-10-15 CAD: adım 2 - NFC okuyucu (RC522 / PN5180) yerleşimi; RC522 pin kenarı raylara giriş ucunda
    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
2026-10-15 CAD: adım 3 - 18650 pil yatağı (taban plakası cebi + kablo bağı yarıkları); taban tutucuları adım adım
    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
2026-10-15 CAD: montaj görseli - üst modül (kabuk, halka, NFC, mikrofon, anahtar) ve alt kapak (pil, hoparlör, ESP32, TP4056, amfi)
    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
2026-10-15 CAD: mikrofon şimdilik çıkarıldı (MIKROFON=False, yeri ayrılı); montaj görselinde parça adları
    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
2026-10-15 CAD: adım 4 - yuvarlak Ø50 hoparlör önde dik (beşik, ses yakası, ön ızgara), logo ızgaranın üstünde
    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
2026-10-15 CAD: adım 5 - TP4056 Type-C yuvası (tırnaklı duvarlar, arka dayanak), USB-C için düz iç yüz + dış fiş oyuğu; pil 5 mm öne
    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
2026-10-15 CAD: TP4056 ölçüleri ürün sahibinin HW-373 STL'sinden (28x17,3x1, USB-C 9,8x3, 1,5 mm taşma); görsellerde gerçek model
    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
2026-10-15 CAD: USB-C dış yüzle 0'a 0 - duvar içten 1,5 mm'ye inceltildi, delik USB-C biçiminde, altı açık ve taban plakasının diliyle kapanır; kart kenarı duvara dayanır
    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
2026-10-15 Stand: dış gövde bozulmadan USB-C hizası (TP4056 ortada, 6,5 mm kaidede)
    - Dıştaki düz yüzey kaldırıldı; gövde eğrisi aynen kaldı.
    - TP4056 arkanın ortasına (x=0) ve gövdenin dik kısmına (kart altı 8,9 mm)
    alındı: USB-C kenarları dış yüzle aynı hizada, ortası yalnız 0,4 mm içeride.
    - Duvar içten inceltildi, tabandaki dil gövde eğrisini izliyor.
    - MAX98357A x=21'e, KCD11 235°'ye kaydı; iki NFC varyantında çakışma 0.
    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
2026-10-15 Stand: ESP32-S3 ürün sahibinin STEP'ine göre arkaya, ters (jumper'lar üstten)
    - STEP (cad/parca_stl/esp32s3_devkit.step) gmsh ile STL'e çevrildi: kart 57,2 x 28,5 x 1,6,
    anten ucu +6,7, pinler alttan 8,1 mm.
    - Kart TERS yatar (bileşenler aşağı, pinler yukarı): dişi jumper (14 mm) + büküm için
    pinlerin üstünde 18 mm boşluk (z 22-40), hiçbir parçaya değmiyor.
    - Yuva taban plakasında: iki kanal (iç kiriş kartı taşır, dış duvar tutar), TP4056
    üstünden köprü, USB-C ucunda iki köşe kancası, anten ucunda esnek tırnak. Ayrı raf
    parçası kaldırıldı.
    - Yer açmak için: pil 6 mm öne, MAX98357A sağ öne, KCD11 sol yana (155°), arka sağ
    vida 330°'y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
2026-10-15 Stand adım 7: KCD11 açma-kapama yuvası (sol yan, düz oturma yüzü + içte düz panel)
    - Flanş eğri gövdeye düz otursun diye dışta sığ oturma yüzü (ortada 0,8 mm gömülü,
    dışa hiçbir şey eklenmedi); içte tırnaklar için 1,6 mm düz panel.
    - Anahtar zarfı gerçekçi (gövde, flanş, tuş); kabukla çakışma artık denetleniyor (0).
    - adim_7_anahtar_yakin.png: dıştan görünüş ve eksenden kesit. Ölçüler tahmin.
    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
2026-10-15 Stand: baskıya hazır STL paketi (parça parça + montajlı tüm hâli), figür tabanı Ø28
    - stl_cakil/<nfc>/: 1_kabuk, 2_taban_plakasi, 3_halka_nfc_tutucu, 4_figur_taban,
    5_ayar_karti baskı yönünde ve tablada; 0_tum_stand_*_montajli (tüm hâli) ve
    elektronikli görsel model. Hepsi su geçirmez, tek gövde.
    - Hata düzeltildi: kabuğun 4 direği tutucu plakanın içine 2 mm giriyordu; direkler
    artık plakanın üstünde başlıyor. Denetim basılan parçalar arası çakışmayı da arıyor.
    - Tutucudaki halka bileziği kaldırıldı (halkayı tavandaki oyuğa giren LED'ler
    ortalıyor): plaka düz, desteksiz ters basılır; kablo çentiği plakadan geçer.
    - Yeni figür tabanı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
2026-10-16 Stand: montaj delikleri düzeltildi (M3 havşa, M2,5 kılavuz)
    - Taban plakası: havşa konisi alt yüzden başlamıyordu (0,6 mm boyun kalıyordu);
    M3 havşa başlı vidanın başı artık alt yüzle aynı hizada oturur.
    - Kabuğun 4 direği: kılavuz delik tavanla birleşince 1,6 mm'de kapanıyordu; artık
    3 mm derin (üst yüzde 1 mm et kalır, dışta iz yok).
    - Tutucu vida tablası 3,5 mm'ye kalınlaştı (M2,5 x 6 vidaya göre).
    - BENIOKU: vida ve ısıl gömme somun ölçüleri.
    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
2026-10-16 Stand: Bambu P2S (AMS) için 4 renkli kabuk (3MF + renk başına STL)
    - cad/renkli.py: kabuk 4 renk bölgesine bölünür (beyaz gövde ve ışık halkası,
    turkuaz "eco ai" ve çukur zemini, sarı çukur kenarı ve güneş halkası, mor 6 yıldız);
    parçalar birbirine değmez, toplam hacim kabukla aynı, hepsi su geçirmez.
    - stl_cakil/renkli_bambu/kabuk_renkli_bambu.3mf: Bambu Studio proje biçimi, parçalar
    filament 1-4'e atanmış (lib3mf katı modda 0 uyarı); yedek olarak renk başına STL.
    - BENIOKU: AMS yuva/renk tablosu ve yükleme adımları; onizleme/renkli_kabuk.png.
    Claude-Session: https://claude.ai/code/session_013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
2026-10-16 Stand: tüm parçalar 4 renkli (Bambu P2S / AMS)
    - renkli.py genelleştirildi: kabuk, taban plakası (alt yüzde turkuaz "eco ai", sarı
    halka, mor yıldızlar), halka/NFC tutucu (beyaz, turkuaz "ÖN" + ok), figür tabanı
    (turkuaz, sarı halka), ayar kartı (mor, topuzda beyaz çark, sarı halka).
    - Parça başına Bambu 3MF (filament 1-4 atanmış); 11 figür tabanı + ayar kartı tek
    tablada. lib3mf katı modda 0 uyarı; tüm renk STL'leri su geçirmez.
    - BENIOKU: AMS sırası ve dosya tablosu; onizleme/renkli_parcalar.png.
    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
2026-10-17 Stand: montaj rehberi görseli (her parça nereye gelir, numaralı)
    - cad/yerlesim_gorsel.py -> onizleme/yerlesim_rehberi.png: patlatılmış 3B görünüş,
    alt kapak üstten, üst kabuk alttan (ters), ortadan yan kesit; 12 parça numaralı,
    vida yerleri ve jumper boşluğu işaretli.
    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
2026-10-17 Stand: hoparlör mıknatıs eyeri yarıçapı 21 mm (ürün sahibi)
    - PARCA["hoparlor_miknatis_r"] = 20,7: eyer kesiti 21,0 (0,3 pay), eyer 36 mm geniş;
    hoparlör zarfındaki mıknatıs da buna göre (çakışma denetimi 0).
    - STL, renkli 3MF, STEP ve görseller yeniden üretildi.
    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
2026-10-19 Figür tabanları: vidalı NFC kapağı (şişe kapağı gibi), her figür için baskı dosyası
    - cakil_ic: figür tabanı Ø28 x 8 (5 mm çukurda) + altına vidalanan fincan kapak
    (adım 2, 1,5 tur, 0,35/0,25 mm boşluk); Ø20 NTAG213 kapağın içine yapışır,
    antene 2,9 mm. Kapağın altında para yarığı, figür adı ve NFC numarası.
    - geometri.vida_cubugu: dişi burularak uzatılmış kesitle kurar (aynı adımla
    dişi/erkek eşleşir); takılı ve döndürerek sökülürken çakışma 0, ters yönde çakışır.
    - Ay Dede: tabanla tek parça uyuyan hilal ay. Ayar kartı: topuzlu taban + kapak.
    - figurler.py -> stl_cakil/figurler/: 12 figür + ayar kartı (taban + adlı kapa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
2026-10-19 figur_tabanla.py: hazır figür STL'sinin altına vidalı NFC kapaklı taban ekler
    - Figür ayak izinin ortası tabanın ortasına, 0,6 mm gömülü; --boy ölçekler, --kes
    figürün kendi kaidesini keser, --dondur yatık gelen STL'yi düzeltir.
    - Kapalı olmayan ağ onarılır; olmazsa figür ve taban ayrı gövde yazılır.
    - Adlı ve numaralı kapak yanına konur; tabana değen alan küçükse uyarır.
    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
2026-10-19 Stand v2 (ilk baskıdan sonra): Ø55/Ø70 halka, Ø52 figür yuvası, USB-C kanalı, ikinci eyer
    Ürün sahibinin ilk baskı geri bildirimi (20 Ekim 2026):
    - LED halka iç Ø55 / dış Ø70: çukurun dış duvarı Ø54,9 (halkaya sıkı geçer), içi
    Ø52,5; ışık oyuğu r 28-34,6, 36 ışık penceresi. Tutucu halkayla büyüdü (Ø75);
    rayların çukur zeminine giren üstü kesildi.
    - Figür tabanı Ø52, vidalı kapak Ø30 diş, içinde Ø25 NTAG213. Ay Dede büyütüldü.
    - USB-C: kızak kanalı 0,15 -> 0,4 mm, dudak arası kart + 0,8; delik +0,6; dışta
    fiş gövdesi cebi 12,8 x 7,2 (fiş dişinin yüzüne kadar oturur).
    - Hoparlör: mıknatıs eyerinin aynısı içeride; üç d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
2026-10-19 Stand v3: USB-C yuvası yeniden (kızak yok, ince cep yok, delik büyük)
    İlk baskıda kabuktaki kızaklar ters baskıda havada kaldı, destekle dolup kapandı;
    içteki geniş inceltme cebi duvarı 1,1-1,9 mm'ye indirip dış yüzde pürüz yaptı;
    delik küçük geldi.
    - Kızaklar ve geniş iç cep kaldırıldı. Kartın ön kenarı duvardaki ince düz banda
    dayanır (bantta duvar en az 1,4 mm); fiş cebi dışında duvar 2,4 mm.
    - USB-C deliği dişiden 0,8 mm büyük; dıştaki 12,8 x 7,2 fiş cebi dişinin ön
    yüzüne kadar iner (dişi merkezde yüzeyden 1,0 mm içeride, fiş tam oturur).
    - Tabandaki dayanak esnek, tırnağı kartın arka kenarına üstten biner (basamaklı
    pahla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
2026-10-21 Stand v4: 4'lü AA pil kutusu, alttan vidalı pil kapağı; USB-C, 18650 ve TP4056 kalktı
    - Taban plakasının ortasında pil kutusu (yatak ters, piller alttan); kapak plakayla aynı hizada:
    solda iki 45° pahlı dil, sağda M3 havşa vida + ısıl gömme somun, tırnak çentiği
    - ESP32-S3 kutunun üstüne çıktı ve 180° döndü (J1 öne, USB-C sağda); MAX98357A ve 5 V düzenleyici
    kutunun tavanında; anahtar z 28'e; ayaklar ve 210° vidası kapağın dışına; ikinci hoparlör eyeri kalktı
    - STEP için geometri(_occ).py'ye xy_prizma ve aynala_x; renkli pil kapağı 3MF
    - İki NFC sürümünde de çarpışma denetimi 0 sorun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
2026-10-21 Stand v5: tutucu vidasız (Ø5 pim + kaburgalı tabla), direkler hoparlörden uzak, alt modül kabuğun ağzından geçer
    - Ürün sahibi: hoparlör beşiğinin sağ kolu kabuğa takılıyordu -> taban plakasındaki her şey kabuğun alt
    ağzının (r 55,0) içinde; denetim kabuğu alt modülün üstüne indirmeyi de dener
    - Tutucu direkleri 38/142/218/322°; tutucu kabuğun 4 pimine sıkı geçer (10 mm pim, tutucu birkaç mm
    aşağıda kalsa da tutar)
    - ESP32 y -32,7 (köşeleri ağızdan geçer), jumper payı 14 + 2 mm
    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
2026-10-23 Kedi kulakları: ayrı basılan iki kulak (dilli, iç kakmalı), kabuğun omzunda iki yuva + içte kaide
    - cakil_ic.py: KULAK_* ölçüleri, kulak_yer / kulak_dilleri; kabukta yuva ve kaide (dil dışarıdan görünmez)
    - kulaklar.py --kedi: stl_cakil/kulak/*.stl, renkli_bambu/6_kedi_kulaklari.3mf, onizleme/kedi_kulaklari.png
    - Kabuğun bütün çıktıları yeniden üretildi (çarpışma denetimi 0 sorun)
    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
2026-10-23 renkli.py kedi kulaklarının 3MF'ini de üretir (klasör temizlenince silinmesin)
    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
2026-10-23 Kulaksız kabuk: yuvasız 1_kabuk_kulaksiz.stl / .3mf (kabuk(kulak=False))
    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
2026-10-26 Kör kıyas c3ft_karma2 – c3ft_karma: 164 vaka, 4 parti hakemlere hazır (anahtar hakemlik süresince klasör dışında)
    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
2026-10-26 Kör kıyas sonucu: c3ft_karma2 (16,5 bin) – c3ft_karma (10,6 bin) fark yok (genel 83–81, olay 83–77)
    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
2026-11-02 c3ft_v5a kör kıyası: ürün modelini açık farkla geçti (genel 106–58, olay 96–62)
    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
2026-11-09 Ürün figürleri: Keloğlan + 12 lisanssız figür (NFC 13-24) kart, web ve CAD'e taşındı
    - urun_uret.FIGURLER data/urun_figurleri.json'dan (13 figür); eski 10 lisanslı figür
    ESKI_FIGURLER'de, adları isim süzgecinde ve seçicide yasak kalıyor.
    - figur_donanim.json sürüm 3: yeni figürler NFC 13-24, lisanslılar 'cikarildi' (numaralar
    yeniden kullanılmaz). generated/ başlıkları ve sozluk.h yeniden üretildi.
    - CAD: yeni figür tabanları ve NFC kapakları, kontrol raporu HATA YOK.
    - Eşitlik: kart_pc_karsilastir (hf_c3ft_v5a) 52 aday 0 uyuşmazlık; secici_karsilastir
    --urun 872 aday 0 uyuşmazlık. pytest 359 geçti, 8 kırık (kapi.py plan kuralı 'tek tek'i
    Tek Boyn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
2026-11-09 Kör kıyas v5: son model ara modeli geçti (genel 102–78, olay 99–73)
    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
2026-11-09 Keloğlan kıyası (v5 – karma): üretim sürüyor (yer tutucu özet dosyaları)
    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
2026-11-09 Keloğlan kıyası (v5 – karma): 48 vaka hikâyeleri ve kör parti
    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
2026-11-09 Keloğlan kıyası: son model ürün modelini geçti (genel 34–14, olay 29–15)
    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
